Oru-star/Unique-DAP/ASSETS/Same_Sky_SJ1-3533NG/BOM.txt

3DX_Same_Sky_Supplier: Same Sky
3DX_Same_Sky_Description: 3.5 mm Right-Angle Stereo Jack, 3 Pin PCB Mount, Isolated Ground
3DX_Same_Sky_Model Number: SJ1-3533NG
