Oru-star/Unique-DAP/Bom.csv

Category | RefDes | Qty | Item / value | Manufacturer | MPN / candidate | Datasheet / manufacturer reference | Purchase / distributor link | Unit price (INR) | Unit price (USD) | Extended price (INR) | Extended price (USD) | Price basis / source note | Status | Source URL | Engineering audit notes | Price confidence | FX rate used (INR per USD)
Display | DISP1 | 1 | 3.16-in reflective memory LCD, 336 × 536, serial interface | Sharp | LS032B7DD02 | https://global.sharp/products/device/lineup/selection/lcd/mobile/index.html | https://www.digikey.in/en/products/detail/sharp-microelectronics/LS032B7DD02/23349498 | 3739.83 | 39.8483 | 3739.83 | 39.85 | Existing BOM price; reconfirm supplier/stock | VERIFY |  | Sharp confirms 3.16 in, 336×536, serial reflective display. Product brief states 5 V input; verify the complete panel power/logic requirements and FPC pinout against the exact revision before PCB release. | Exact DigiKey India listing observed; price can change | 93.8516
DAC | IC1 | 1 | 32-bit stereo audio DAC | ESS Technology | ES9038Q2M | https://www.mouser.in/c/?q=ES9038Q2M | https://www.mouser.in/c/?q=ES9038Q2M | 1967.96 | 20.9688 | 1967.96 | 20.97 | Mouser India single-unit listing | BUY | https://www.mouser.in/en/ProductDetail/ESS-Technology/ES9038Q2M | Exact DAC MPN. Verify exposed-pad/package land pattern, analog/digital supply rails, MCLK limits and output topology against the current datasheet. | Legacy price from earlier draft; recheck at checkout | 93.8516
Power IC | U1 | 1 | 3.7-A boost converter | Texas Instruments | TPS61023DRLR | https://www.ti.com/product/TPS61023/part-details/TPS61023DRLR | https://www.digikey.in/en/products/result?keywords=TPS61023DRLR | 116.56 | 1.242 | 116.56 | 1.24 | Existing BOM price; reconfirm at checkout | BUY | https://www.mouser.in/ | TI calls 3.7 A the valley switch-current limit, NOT guaranteed 3.7 A output current. 74438357010 is listed by TI as a recommended 1 µH inductor; re-check peak current, thermal and output-current budget. | Legacy price from earlier draft; recheck at checkout | 93.8516
Power IC | U2 | 1 | Buck-boost converter | Texas Instruments | TPS63021DSJR | https://www.ti.com/product/TPS63021/part-details/TPS63021DSJR | https://www.digikey.in/en/products/detail/texas-instruments/TPS63021DSJR/2271632 | 384.11 | 4.0927 | 384.11 | 4.09 | Existing BOM price; reconfirm at checkout | BUY |  | Active TI 3.3 V buck-boost part. Check inductor selection and output-current capability at battery minimum voltage. | Legacy price from earlier draft; recheck at checkout | 93.8516
Charger IC | U3 | 1 | 1-cell Li-ion/Li-poly charger with power-path management | Texas Instruments | BQ25895RTWR | https://www.ti.com/product/BQ25895 | https://www.digikey.in/en/products/detail/texas-instruments/BQ25895RTWR/5214018 | 321.05 | 3.4208 | 321.05 | 3.42 | Existing BOM price; reconfirm at checkout | VERIFY |  | 1-cell charger, 24-WQFN, max 5 A charge-current family. Confirm NTC/TS pin bias, battery profile, power-path and thermal layout. Do not omit battery temperature sensing without a documented safe configuration. | Exact DigiKey India listing observed; price can change | 93.8516
USB-C controller | U4 | 1 | USB Type-C configuration channel controller | Texas Instruments | TUSB320LAIRWBR | https://www.ti.com/product/TUSB320LAI/part-details/TUSB320LAIRWBR | https://www.digikey.in/en/products/detail/texas-instruments/TUSB320LAIRWBR/5722618 | 174.05 | 1.8545 | 174.05 | 1.85 | DigiKey India, qty 1 | BUY | https://www.digikey.in/en/products/detail/texas-instruments/TUSB320LAIRWBR/5722618 | Active Type-C CC controller; verify UFP/DFP/DRP role configuration and CC wiring against the intended charging/data port topology. | Exact DigiKey India listing observed; price can change | 93.8516
Headphone amplifier | U5 | 1 | Stereo DirectDrive headphone amplifier | Analog Devices / Maxim | MAX97220AETE+T | https://www.analog.com/en/products/max97220a.html | https://www.digikey.in/en/products/detail/analog-devices-inc-maxim-integrated/MAX97220AETE-T/2744332 | 245.56 | 2.6165 | 245.56 | 2.62 | DigiKey India, qty 1; replaces prior BOM estimate | BUY | https://www.digikey.in/en/products/detail/analog-devices-inc-maxim-integrated/MAX97220AETE-T/2744332 | Exact orderable suffix is MAX97220AETE+T. 16-TQFN; verify exposed-pad and analog supply/charge-pump capacitor layout. | Exact DigiKey India listing observed; price can change | 93.8516
MCU module | U6 | 1 | ESP32-S3 Wi-Fi/Bluetooth module; 8 MB flash + 8 MB PSRAM | Espressif | ESP32-S3-WROOM-1-N8R8 | https://www.espressif.com/en/products/modules/esp32-s3-wroom-1 | https://www.digikey.in/en/products/detail/espressif-systems/ESP32-S3-WROOM-1-N8R8/16705630 | 603.88 | 6.4344 | 603.88 | 6.43 | Existing BOM price; reconfirm exact suffix and supplier | VERIFY |  | Exact module is 8 MB Quad-SPI flash + 8 MB Octal-SPI PSRAM; check GPIO restrictions for octal PSRAM and antenna keepout. | Exact DigiKey India listing observed; price can change | 93.8516
USB-C receptacle | J1 | 1 | USB 2.0 Type-C top-mount receptacle | GCT | USB4105-GF-A | https://gct.co/connector/usb4105 | https://www.digikey.in/en/products/detail/gct/USB4105-GF-A/11198510 | 76.44 | 0.8145 | 76.44 | 0.81 | DigiKey India, qty 1 | VERIFY | https://www.digikey.in/en/products/detail/gct/USB4105-GF-A/11198510 | USB 2.0 Type-C receptacle. Verify footprint, shell stakes, orientation, CC pins and whether this is the charge-only or audio/data port. | Exact DigiKey India listing observed; price can change | 93.8516
Battery header | J2 | 1 | 2-position 2.54 mm straight through-hole pin header | Samtec | TSW-102-07-G-S | https://www.samtec.com/products/tsw-102-07-g-s | https://www.digikey.in/en/products/result?keywords=TSW-102-07-G-S | 20.07 | 0.2138 | 20.07 | 0.21 | Existing BOM price; reconfirm supplier | VERIFY |  | 2-pin 2.54 mm header is not polarized. For a LiPo battery this is a shorting/reverse-connection risk; prefer a keyed, locking battery connector matched to battery lead. | Legacy price from earlier draft; recheck at checkout | 93.8516
Programming header | J3 | 1 | 5-position 2.54 mm straight through-hole pin header | Samtec | TSW-105-07-G-S | https://www.samtec.com/products/tsw-105-07-g-s | https://www.digikey.in/en/products/result?keywords=TSW-105-07-G-S | 40.66 | 0.4332 | 40.66 | 0.43 | Existing BOM price; reconfirm supplier | BUY |  | 5-pin 2.54 mm header candidate; verify pin order, mating housing and programming fixture. | Legacy price from earlier draft; recheck at checkout | 93.8516
Display FPC connector | J4 | 1 | 10-position 0.5 mm FPC/FFC ZIF connector, right-angle | Hirose | FH34SRJ-10S-0.5SH(50) | https://www.hirose.com/en/product/p/CL0580-1251-5-50 | https://www.digikey.in/en/products/detail/hirose-electric-co-ltd/FH34SRJ-10S-0-5SH-50/3880296 | 116.57 | 1.2421 | 116.57 | 1.24 | Mouser India, qty 1 | VERIFY | https://www.mouser.in/en/ProductDetail/Hirose-Connector/FH34SRJ-10S-05SH50 | Hirose confirms 10-position, 0.5 mm, ZIF, right-angle, 0.3 mm FPC. Confirm contact orientation and exact Sharp flex thickness/pinout. | Exact DigiKey India listing observed; price can change | 93.8516
Headphone jack | J5 | 1 | 3.5 mm stereo TRS right-angle through-hole jack, unswitched | Same Sky / CUI Devices | SJ1-3533NG | https://www.digikey.in/en/products/detail/same-sky-formerly-cui-devices/SJ1-3533NG/738701 | https://www.digikey.in/en/products/detail/same-sky-formerly-cui-devices/SJ1-3533NG/738701 | 160.74 | 1.7127 | 160.74 | 1.71 | DigiKey India, qty 1 | BUY | https://www.digikey.in/en/products/detail/same-sky-formerly-cui-devices/SJ1-3533NG/738701 | Active unswitched stereo TRS jack. Verify PCB footprint and mechanical insertion depth with enclosure. | Exact DigiKey India listing observed; price can change | 93.8516
Ferrite bead | FB1 | 1 | 600 Ω @ 100 MHz ferrite bead, 0805 | Murata | BLM21PG601SN1D | https://www.murata.com/en-global/products/productdetail?partno=BLM21PG601SN1D | https://www.digikey.in/en/products/detail/murata-electronics/BLM21PG601SN1D/24763118 | 11.47 | 0.1222 | 11.47 | 0.12 | Existing BOM price; reconfirm supplier | VERIFY |  | Active 0805 600 Ω @100 MHz ferrite bead. Verify DC current and DCR against rail load; impedance alone is not enough. | Exact DigiKey India listing observed; price can change | 93.8516
Power inductor | L1 | 1 | 1.0 µH shielded power inductor; TI-listed candidate | Würth Elektronik | 74438357010 | https://www.we-online.com/en/components/products/WE-MAPI | https://in.element14.com/wurth-elektronik/74438357010/inductor-1uh-7-4a-20-shielded/dp/2842181 | 161.46 | 1.7204 | 161.46 | 1.72 | Existing BOM price; supplier listing approx. ₹162.82; reconfirm | HOLD | https://in.element14.com/wurth-elektronik/74438357010/inductor-1uh-7-4a-20-shielded/dp/2842181 | TI-recommended 1 µH candidate for TPS61023. Datasheet electrical current ratings differ from some distributor summary fields; compare the manufacturer's current datasheet and operating peak current before approval. | Legacy price from earlier draft; recheck at checkout | 93.8516
Power inductor | L2 | 1 | 1.5 µH shielded power inductor; Coilcraft candidate | Coilcraft | XFL4020-152ME | https://www.coilcraft.com/en-us/products/power/shielded-inductors/xfl/xfl4020/ | https://www.digikey.in/en/products/result?keywords=XFL4020-152ME |  |  |  |  | No verified India single-unit price found; request quote | HOLD |  | Generic family suffix may not be a complete orderable MPN; Coilcraft/Mouser show MEB/MEC variants. Confirm exact suffix and verify Isat/DCR against TPS63021 worst-case inductor current. | No verified price; quotation required | 93.8516
Power inductor | L3 | 1 | 2.2 µH shielded power inductor | Murata | DFE322512F-2R2M=P2 | https://www.murata.com/en-global/products/productdetail?partno=DFE322512F-2R2M%3DP2 | https://www.digikey.in/en/products/detail/murata-electronics/DFE322512F-2R2M-P2/9815914 | 46.82 | 0.4989 | 46.82 | 0.5 | DigiKey India, qty 1 | HOLD | https://www.digikey.in/en/products/detail/murata-electronics/DFE322512F-2R2M-P2/9815914 | Price/listing found, but L3 function is not explicit in the BOM. HOLD until assigned rail and Isat/DCR are checked at worst-case current. | Exact DigiKey India listing observed; price can change | 93.8516
Oscillator | Y1 | 1 | 40.000 MHz CMOS oscillator, 3.3 V, 4-pad 3.2 × 2.5 mm | Abracon | ASE-40.000MHZ-L-C-T | https://abracon.com/Oscillators/ASE.pdf | https://www.digikey.in/en/products/detail/abracon-llc/ASE-40-000MHZ-L-C-T/5980161 | 99.37 | 1.0588 | 99.37 | 1.06 | DigiKey India, qty 1 | VERIFY | https://www.digikey.in/en/products/detail/abracon-llc/ASE-40-000MHZ-L-C-T/5980161 | 40 MHz oscillator price/link found. HOLD: confirm ES9038Q2M MCLK requirement and supported sample-rate clock plan; 40 MHz may not provide clean integer-family clocks for 44.1/48 kHz. | Exact DigiKey India listing observed; price can change | 93.8516
Capacitor | C1,C8-C10,C13,C14,C30 | 7 | 10 µF MLCC, 0603; suggested 10 V X5R | Samsung (candidate) | CL10A106KP8NNND | https://www.samsungsem.com/global/product/passive-component/mlcc.do | https://www.digikey.in/en/products/result?keywords=CL10A106KP8NNND | 19.11 | 0.2036 | 133.77 | 1.43 | DigiKey India single-unit price; limited stock shown | VERIFY | https://www.digikey.in/en/products/detail/samsung-electro-mechanics/CL10A106KP8NNND/3894249 | 10 µF 0603 candidate. Verify voltage rating, X5R effective capacitance under DC bias, and temperature range on the actual rail. | Legacy price from earlier draft; recheck at checkout | 93.8516
Capacitor | C2,C16-C21,C23,C28,C31 | 10 | 100 nF MLCC, 0603; suggested 50 V X7R | Murata | GRM188R71H104KA93D | https://www.murata.com/en-global/products/productdetail?partno=GRM188R71H104KA93D | https://www.digikey.in/en/products/detail/murata-electronics/GRM188R71H104KA93D/587143 | 15.29 | 0.1629 | 152.9 | 1.63 | DigiKey India single-unit price | VERIFY | https://www.digikey.in/en/products/detail/murata-electronics/GRM188R71H104KA93D/587143 | 100 nF, 50 V, X7R 0603 exact part is marked obsolete on DigiKey. Select a current-life replacement after checking tolerance and package. | Legacy price from earlier draft; recheck at checkout | 93.8516
Capacitor | C3-C6 | 4 | 22 µF MLCC, 0603, 6.3 V X5R | Yageo | CC0603MRX5R5BB226 | https://www.yageo.com/en/ProductSearch/Index | https://www.digikey.in/en/products/result?keywords=CC0603MRX5R5BB226 | 54.46 | 0.5803 | 217.84 | 2.32 | Existing BOM price; reconfirm exact stock/price | HOLD |  | 22 µF, 6.3 V in 0603. HOLD: 6.3 V rating gives little margin on a 5 V rail; check DC-bias derating/effective capacitance and rail assignment. | Legacy price from earlier draft; recheck at checkout | 93.8516
Capacitor | C7,C12,C24-C27,C29,C32,C34,C35 | 10 | 1 µF MLCC, 0603, 16 V X7R | TDK (direct substitute candidate) | C1608X7R1C105K080AC | https://product.tdk.com/en/search/capacitor/ceramic/mlcc/info?part_no=C1608X7R1C105K080AC | https://www.digikey.in/en/products/result?keywords=C1608X7R1C105K080AC | 11.47 | 0.1222 | 114.7 | 1.22 | DigiKey India direct substitute price; original Murata MPN is obsolete | VERIFY | https://www.digikey.in/en/products/detail/murata-electronics/GRM188R71C105KA12D/965914 | Check exact MPN, package, ratings, lifecycle, footprint and application requirements against manufacturer datasheet. | Legacy price from earlier draft; recheck at checkout | 93.8516
Capacitor | C15,C22,C36-C39 | 6 | 4.7 µF MLCC, 0603; suggested 10 V X7R | Murata (candidate) | GRM188R71A475KE15D | https://www.murata.com/en-global/products/productdetail?partno=GRM188R71A475KE15D | https://www.digikey.in/en/products/result?keywords=GRM188R71A475KE15D |  |  |  |  | No verified single-unit price found; request quote | VERIFY |  | 4.7 µF 0603 candidate. Exact price not verified; check stock, voltage rating and DC-bias derating. | No verified price; quotation required | 93.8516
Capacitor | C11 | 1 | 47 nF MLCC, 0603; suggested 25 V X7R | Murata | GRM188R71E473KA61D | https://www.murata.com/en-global/products/productdetail?partno=GRM188R71E473KA61D | https://www.digikey.in/en/products/result?keywords=GRM188R71E473KA61D |  |  |  |  | No verified single-unit price found; request quote | VERIFY |  | 47 nF 0603 candidate. Exact price not verified; verify dielectric, tolerance and voltage rating. | No verified price; quotation required | 93.8516
Capacitor | C33 | 1 | 560 pF C0G/NP0, 50 V, 0603 | Murata | GRM1885C1H561JA01D | https://www.murata.com/en-global/products/productdetail?partno=GRM1885C1H561JA01D | https://www.digikey.in/en/products/detail/murata-electronics/GRM1885C1H561JA01D/586954 | 15.29 | 0.1629 | 15.29 | 0.16 | DigiKey India, qty 1; listing flags not recommended for new design | VERIFY | https://www.digikey.in/en/products/detail/murata-electronics/GRM1885C1H561JA01D/586954 | 560 pF C0G 50 V 0603 candidate. Verify lifecycle status and actual circuit function. | Legacy price from earlier draft; recheck at checkout | 93.8516
Resistor | R4,R6,R7,R9-R11,R15,R16,R18,R19,R27 | 11 | 10 kΩ, 1%, 0805 | Yageo | RC0805FR-0710KL | https://www.yageo.com/en/ProductSearch/Index | https://www.digikey.in/en/products/detail/yageo/RC0805FR-0710KL/730482 | 3.249 | 0.0346 | 35.74 | 0.38 | DigiKey India, 10-piece price break | BUY | https://www.digikey.in/en/products/detail/yageo/RC0805FR-0710KL/730482 | 10 kΩ 1%, 0805 Yageo candidate; verify required resistor power rating and actual design quantity. | Legacy price from earlier draft; recheck at checkout | 93.8516
Resistor | R17,R20-R26 | 8 | 20 kΩ, 1%, 0805 | TE Connectivity | CRG0805F20K | https://www.te.com/en/product-1622825-1.html | https://www.digikey.in/en/products/detail/te-connectivity-passive-product/CRG0805F20K/2380867 | 9.51 | 0.1013 | 76.08 | 0.81 | DigiKey India single-unit price | BUY | https://www.digikey.in/en/products/detail/te-connectivity-passive-product/CRG0805F20K/2380867 | 20 kΩ 1%, 0805 TE candidate; confirm exact package/power rating. | Legacy price from earlier draft; recheck at checkout | 93.8516
Resistor | R5,R8 | 2 | 260 Ω, 1%, 0805 | Yageo (candidate) | RC0805FR-07260RL | https://www.yageo.com/en/ProductSearch/Index | https://www.digikey.in/en/products/result?keywords=RC0805FR-07260RL |  |  |  |  | Exact MPN price not verified; request quote | VERIFY |  | 260 Ω Yageo candidate. Exact listing/price not confirmed; check whether 260 Ω is intentional versus nearby standard value. | No verified price; quotation required | 93.8516
Resistor | R13,R14 | 2 | 4.7 kΩ, 1%, 0805 | Yageo | RC0805FR-074K7L | https://www.yageo.com/en/ProductSearch/Index | https://www.digikey.in/en/products/detail/yageo/RC0805FR-074K7L/727929 | 9.56 | 0.1019 | 19.12 | 0.2 | DigiKey India single-unit price | VERIFY | https://www.digikey.in/en/products/detail/yageo/RC0805FR-074K7L/727929 | 4.7 kΩ 1%, 0805 candidate; verify tolerance/power. | Legacy price from earlier draft; recheck at checkout | 93.8516
Resistor | R1 | 1 | 100 kΩ, 1%, 0805 | Yageo | RC0805FR-07100KL | https://www.yageo.com/en/ProductSearch/Index | https://www.digikey.in/en/products/detail/yageo/RC0805FR-07100KL/730491 | 10.51 | 0.112 | 10.51 | 0.11 | DigiKey India single-unit price | VERIFY | https://www.digikey.in/en/products/detail/yageo/RC0805FR-07100KL/730491 | 100 kΩ 1%, 0805 candidate; verify tolerance/power. | Legacy price from earlier draft; recheck at checkout | 93.8516
Resistor | R2 | 1 | 27.4 kΩ, 1%, 0805 | Yageo | RC0805FR-0727K4L | https://www.yageo.com/en/ProductSearch/Index | https://www.digikey.in/en/products/detail/yageo/RC0805FR-0727K4L/727782 | 9.56 | 0.1019 | 9.56 | 0.1 | DigiKey India single-unit price | VERIFY | https://www.digikey.in/en/products/detail/yageo/RC0805FR-0727K4L/727782 | 27.4 kΩ 1%, 0805 candidate; verify tolerance/power. | Legacy price from earlier draft; recheck at checkout | 93.8516
Resistor | R3 | 1 | 200 kΩ, 1%, 0805 | Yageo | RC0805FR-07200KL | https://www.yageo.com/en/ProductSearch/Index | https://www.digikey.in/en/products/detail/yageo/RC0805FR-07200KL/730671 | 9.56 | 0.1019 | 9.56 | 0.1 | DigiKey India single-unit price | VERIFY | https://www.digikey.in/en/products/detail/yageo/RC0805FR-07200KL/730671 | 200 kΩ 1%, 0805 candidate; verify tolerance/power. | Legacy price from earlier draft; recheck at checkout | 93.8516
Resistor | R12 | 1 | 900 kΩ, 1%, 0805 | Yageo (candidate) | RC0805FR-07900KL | https://www.yageo.com/en/ProductSearch/Index | https://www.digikey.in/en/products/result?keywords=RC0805FR-07900KL |  |  |  |  | Exact MPN price not verified; request quote | VERIFY |  | 900 kΩ candidate; exact orderable MPN/price not verified. Check if value is intentional and ensure Yageo part number exists. | No verified price; quotation required | 93.8516
Rotary encoder | SW2,SW3 | 2 | Incremental rotary encoder with push switch; vertical, 20 mm body class | ALPS Alpine | EC11E family — EC11E15204A3 price candidate | https://tech.alpsalpine.com/e/products/category/enc/ | https://www.digikey.in/en/products/detail/alps-alpine/EC11E15204A3/21721644 | 421.38 | 4.4899 | 842.76 | 8.98 | DigiKey India, exact EC11E15204A3 candidate; note this exact variant has no built-in push switch | HOLD | https://www.digikey.in/en/products/detail/alps-alpine/EC11E15204A3/21721644 | Check exact MPN, package, ratings, lifecycle, footprint and application requirements against manufacturer datasheet. | Price observed for candidate only; functional mismatch remains | 93.8516
Slide / push controls | SW1,SW2-BOOT1,SW4-SW6 | 5 | Control switches; symbol says SW_Push but assigned footprint is Copal CHS-01A slide switch | Nidec Copal | CHS-01A | https://www.nidec.com/en/product/search/category/B102/M101/S100/ | https://www.tanotis.com/products/nidec-copal-electronics-chs-01a-dip-switch-1pos-spst-slide-smd | 169.2 | 1.8028 | 846.0 | 9.01 | Tanotis India price incl. taxes/import duties; verify this is the intended switch function | HOLD | https://www.tanotis.com/products/nidec-copal-electronics-chs-01a-dip-switch-1pos-spst-slide-smd | CHS-01A is a slide/DIP switch, not a momentary pushbutton. Current SW_Push symbol/footprint mapping is inconsistent. HOLD until control function and footprint are reconciled. | Price observed; switch-function mismatch remains | 93.8516
Battery (off-board) | BAT1 (not a PCB footprint) | 1 | Single-cell 3.7 V Li-Po, 2500 mAh project candidate | WLY (project candidate) | WLY104050 — exact supplier/lead configuration TBD | https://www.google.com/search?q=WLY104050%202500mAh%203.7V%20LiPo%20battery | https://www.google.com/search?q=WLY104050%202500mAh%203.7V%20LiPo%20battery%20supplier |  |  |  |  | No reliable exact-match retail price found; quote required | HOLD |  | Check exact MPN, package, ratings, lifecycle, footprint and application requirements against manufacturer datasheet. | No verified price; quotation required | 93.8516
microSD card socket | J6 | 1 | microSD socket, SMT right-angle, push-push, top-mount; card-detect switch | Hirose Electric | DM3AT-SF-PEJM5 | https://www.hirose.com/product/document?clcode=CL0609-0031-0-00&documenttype=Drawing&lang=en | https://www.digikey.in/en/products/detail/hirose-electric-co-ltd/DM3AT-SF-PEJM5/2533565 | 339.2 | 3.6142 | 339.2 | 3.61 | DigiKey India, qty 1; push-in/push-out with switch contacts; verify suffix and footprint mapping | VERIFY | https://www.digikey.in/en/products/detail/hirose-electric-co-ltd/DM3AT-SF-PEJM5/2533565 | Correct Hirose DM3AT push-push, top-mount, right-angle SMT socket. It physically includes card-detect switch contacts; leave them electrically unconnected as requested. Verify footprint and switch-pad mapping. | Exact DigiKey India listing observed; price can change | 93.8516
Storage media | SD1 (off-board) | 1 | 128 GB microSDXC UHS-I memory card, Class 10 / U1 / A1; up to 140 MB/s read | SanDisk | SDSQUAB-128G-GN6MN | https://www.westerndigital.com/products/memory-cards/sandisk-ultra-uhs-i-microsd | https://indiastore-stage.westerndigital.com/store/sdsquab-128g-gn6mn.html | 909.0 | 9.6855 | 909.0 | 9.69 | Western Digital India store listing; price may change | VERIFY | https://indiastore-stage.westerndigital.com/store/sdsquab-128g-gn6mn.html | 128 GB microSDXC candidate. Confirm exact speed class, authenticity, supplier warranty and exFAT/FAT32 firmware support. | Legacy price from earlier draft; recheck at checkout | 93.8516
