Oru-star/Unique-DAP/ASSETS/Adafruit_4694_SHARP_Memory_Display_Reference.step

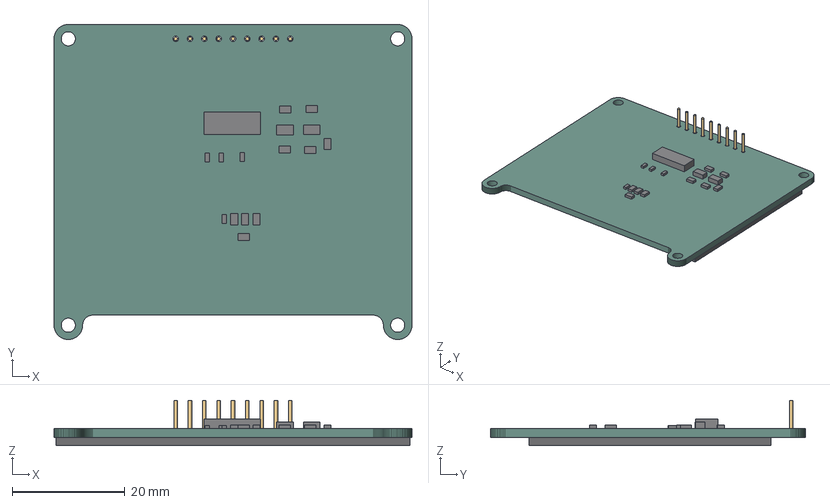
[picture p6: CAD file, 2026-10-27]
ASSETS/Adafruit_4694_SHARP_Memory_Display_Reference.step
63.5 x 55.9 x 7.99 mm
PCB_1p6mm_nominal
Display_module_envelope_estimated_thickness
Viewable_area_58p8x35p3mm
Header_pin_1_estimated
Header_pin_2_estimated
Header_pin_3_estimated
Header_pin_4_estimated
Header_pin_5_estimated
Header_pin_6_estimated
Header_pin_7_estimated
Header_pin_8_estimated
Header_pin_9_estimated
R1_0603-NO_estimated_envelope
R2_0603-NO_estimated_envelope
R3_0603-NO_estimated_envelope
C1_0603-NO_estimated_envelope
C2_0805_10MGAP_estimated_envelope
C3_0805-NO_estimated_envelope
FB1__0805_estimated_envelope
FB2__0805_estimated_envelope
U1_SOIC16_estimated_envelope
U2_SOT23-5_estimated_envelope
C4_0805-NO_estimated_envelope
C5_0805-NO_estimated_envelope
C6_0805-NO_estimated_envelope
C7_0805-NO_estimated_envelope
IC2_SOT23-6_estimated_envelope
C8_0805-NO_estimated_envelope
