Oru-star/Unique-DAP/ASSETS/FH34SRJ-10S-0.5SH_50_/FH34SRJ-10S-0.5SH_50_.step

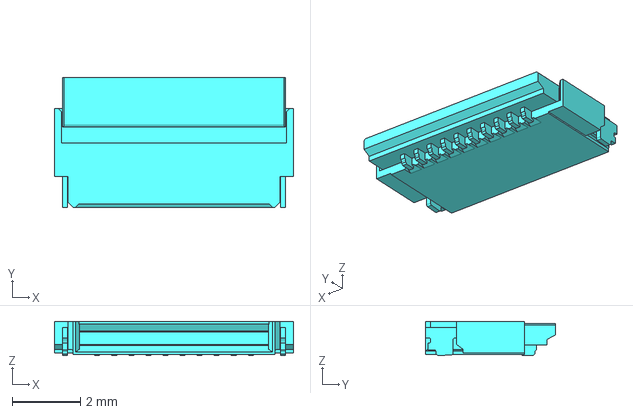
[picture p7: CAD file, 2026-10-27]
ASSETS/FH34SRJ-10S-0.5SH_50_/FH34SRJ-10S-0.5SH_50_.step
7.00 x 3.80 x 1.00 mm
