Oru-star/Unique-DAP/ASSETS/LIB_ES9038Q2M/ES9038Q2M/3D/ES9038Q2M.stp

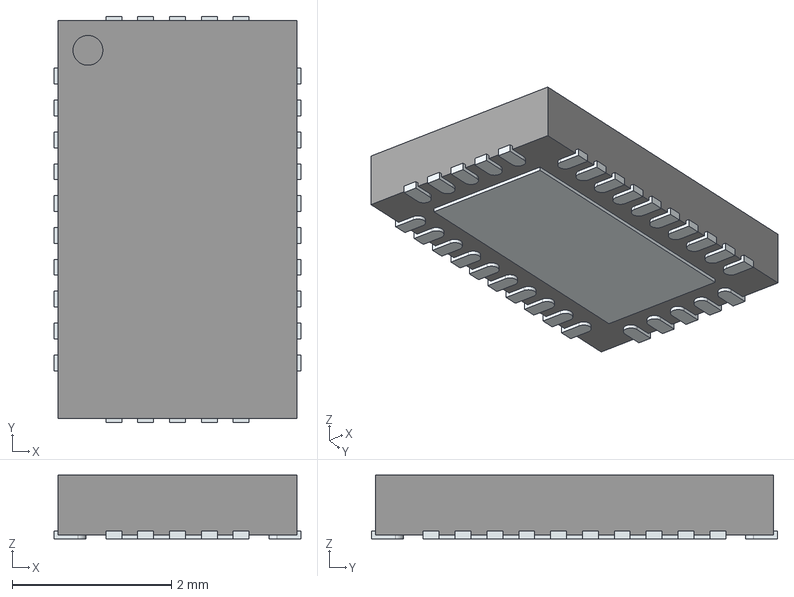
[picture p8: CAD file, 2026-11-07]
ASSETS/LIB_ES9038Q2M/ES9038Q2M/3D/ES9038Q2M.stp
3.10 x 5.10 x 0.8 mm
ThermalPin
PinsArrayLR
PinsArrayTB
