Oru-star/Unique-DAP/ASSETS/Same_Sky_SJ1-3533NG/Same_Sky_SJ1-3533NG.step

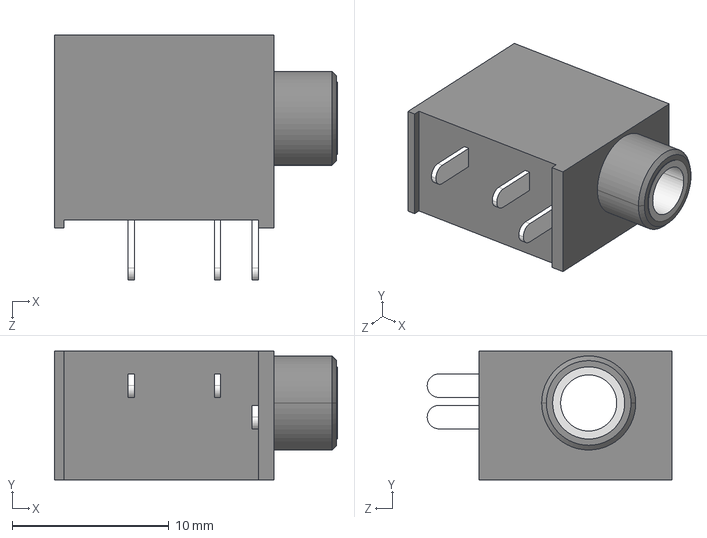
[picture p9: CAD file, 2026-11-11]
ASSETS/Same_Sky_SJ1-3533NG/Same_Sky_SJ1-3533NG.step
18.1 x 8.20 x 15.6 mm
