Oru-star/Unique-DAP/ASSETS/ul_TPS63021DSJR/DSJ0014A.stp

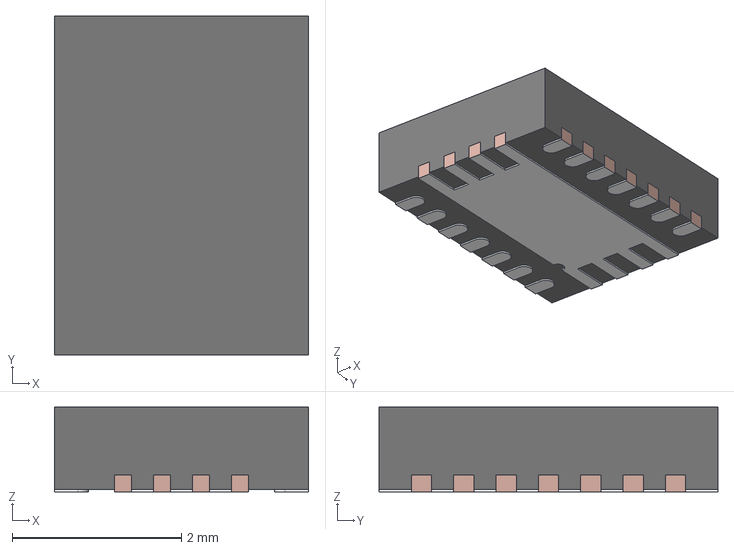
[picture p10: CAD file, 2026-11-07]
ASSETS/ul_TPS63021DSJR/DSJ0014A.stp
3.00 x 4.00 x 1.00 mm
FRAME
MOLD
