Oru-star/Unique-DAP/ASSETS/ul_TUSB320LAIRWBR/RWB0012A.stp

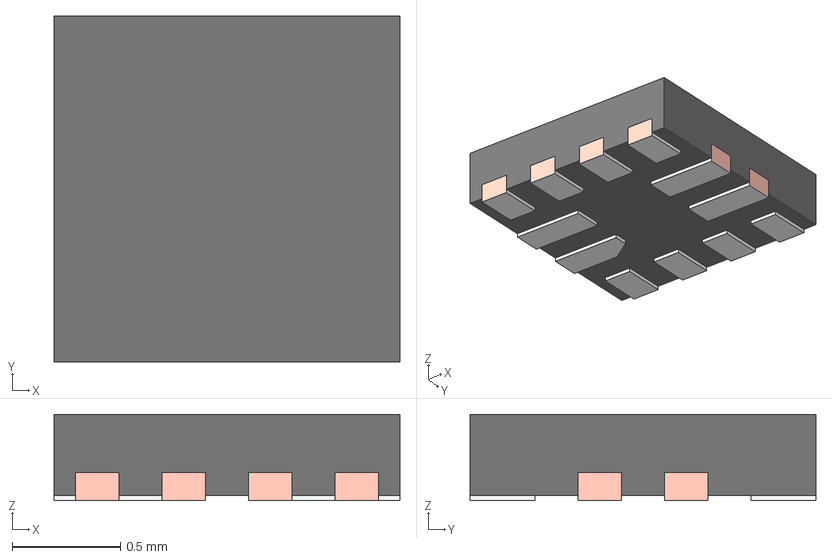
[picture p11: CAD file, 2026-11-07]
ASSETS/ul_TUSB320LAIRWBR/RWB0012A.stp
1.60 x 1.60 x 0.4 mm
FRAME-RWB0012A
BODY-QFN
