Oru-star/Unique-DAP/steps/Stl for prints/Right of Deck .stl

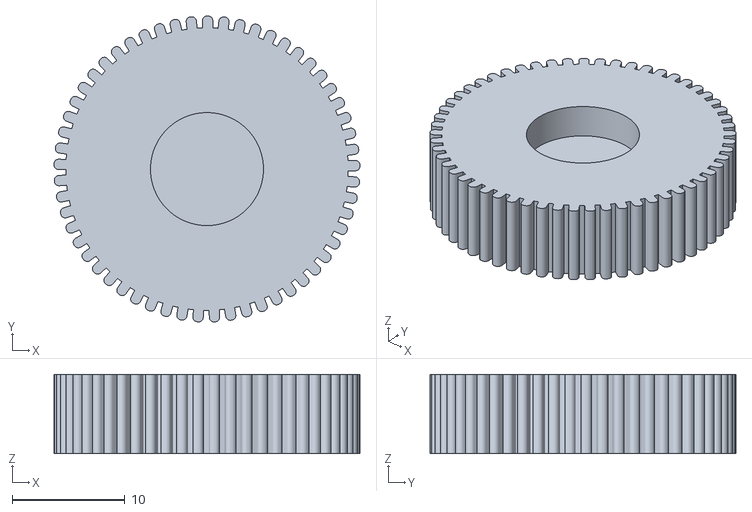
[picture p12: CAD file, 2026-11-11]
steps/Stl for prints/Right of Deck .stl
27.1 x 27.1 x 7.00
