Oru-star/Unique-DAP/ASSETS/Sharp_LS032B7DD02_Envelope_Approx.step

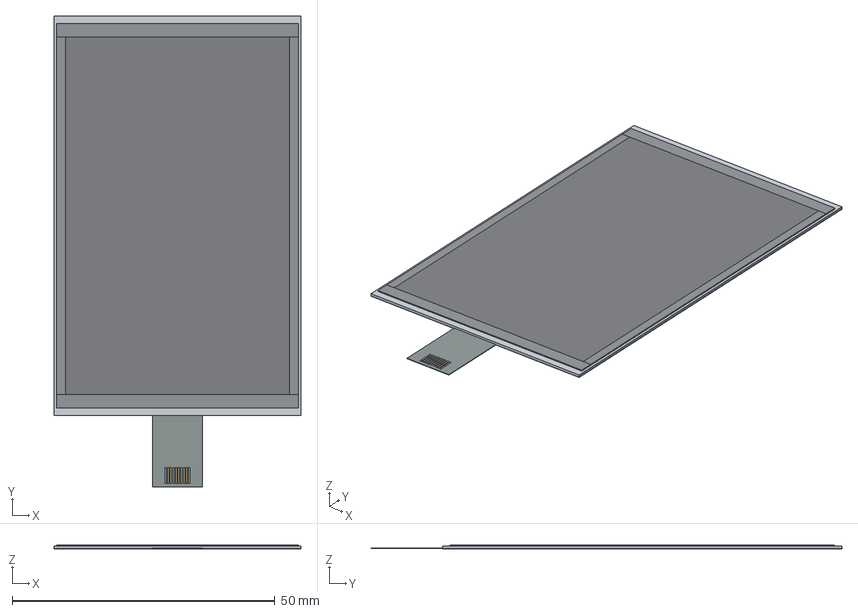
[picture p13: CAD file, 2026-10-27]
ASSETS/Sharp_LS032B7DD02_Envelope_Approx.step
47.0 x 89.6 x 0.705 mm
Bottom_polarizer_0p115mm
Glass_stack_0p400mm
Active_area_42p672x68p072mm
Top_polarizer_left_border
Top_polarizer_right_border
Top_polarizer_top_border
Top_polarizer_bottom_border
FPC_tail_approximate
FPC_contact_01_schematic
FPC_contact_02_schematic
FPC_contact_03_schematic
FPC_contact_04_schematic
FPC_contact_05_schematic
FPC_contact_06_schematic
FPC_contact_07_schematic
FPC_contact_08_schematic
FPC_contact_09_schematic
FPC_contact_10_schematic
