Oru-star/Unique-DAP/steps/Stl for prints/Top of the dap .stl

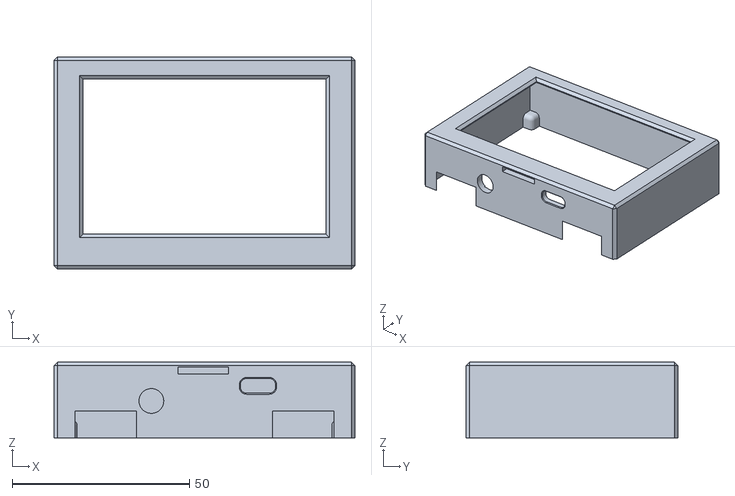
[picture p14: CAD file, 2026-11-11]
steps/Stl for prints/Top of the dap .stl
85.0 x 60.0 x 21.4
