Oru-star/Unique-DAP/ASSETS/EC11_Rotary_Encoder_Switched.step

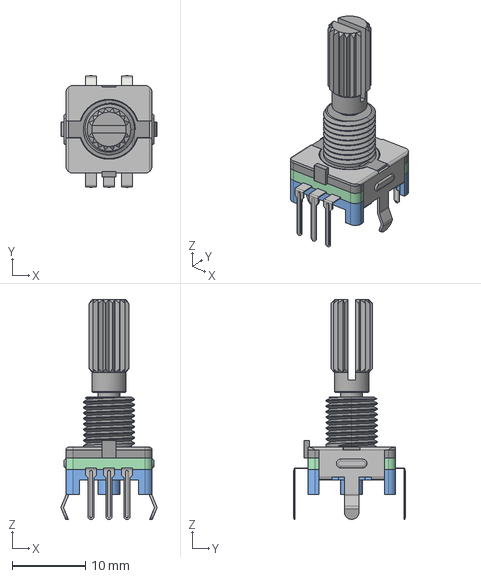
[picture p15: CAD file, 2026-10-27]
ASSETS/EC11_Rotary_Encoder_Switched.step
13.1 x 15.3 x 30.1 mm
