Oru-star/Unique-DAP/steps/Stl for prints/Back of deck .stl

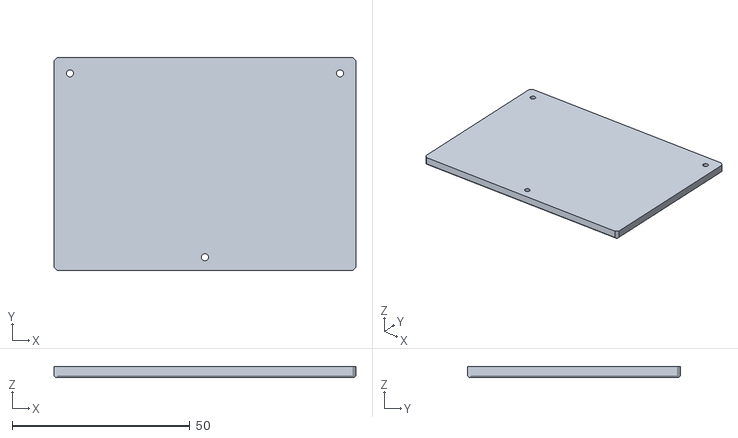
[picture p16: CAD file, 2026-11-11]
steps/Stl for prints/Back of deck .stl
85.0 x 60.0 x 3.00
