Oru-star/Unique-DAP/ASSETS/TPS61023DRLR/TPS61023DRLR.step

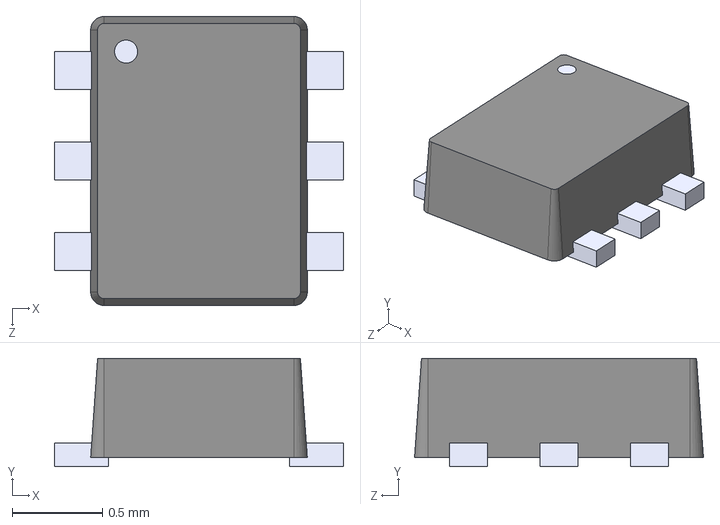
[picture p17: CAD file, 2026-11-07]
ASSETS/TPS61023DRLR/TPS61023DRLR.step
1.60 x 0.6 x 1.60 mm
