Oru-star/Unique-DAP/(list of files, cad)

Other CAD files:
steps/Stl for prints/LEFT SCROLL WHEEL.stl
ASSETS/LIB_ES9038Q2M/ES9038Q2M/Allegro/qfn40p300x500x80-31n-d.psm
ASSETS/LIB_ES9038Q2M/ES9038Q2M/DEHDL/es9038q2m/chips/chips.prt
steps/Main-dap.f3z
