Oru-star/Unique-DAP/ASSETS/carrier-orange pi zero 3w.pdf

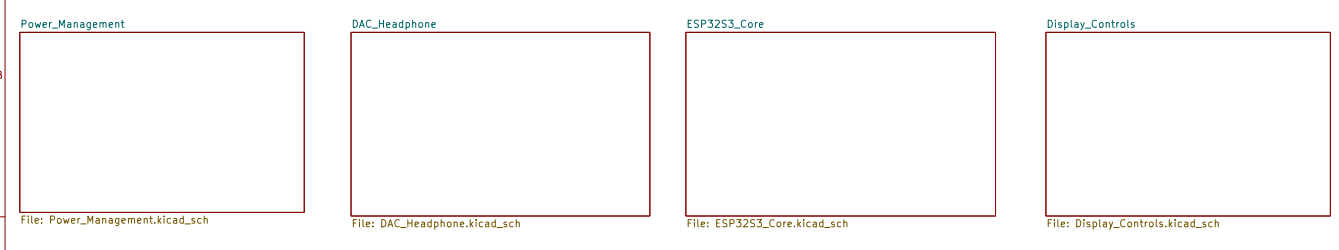
[picture p18: page 1]

Size: A4 | Rev:
KiCad E.D.A. 10.0.6 | Id: 1/5

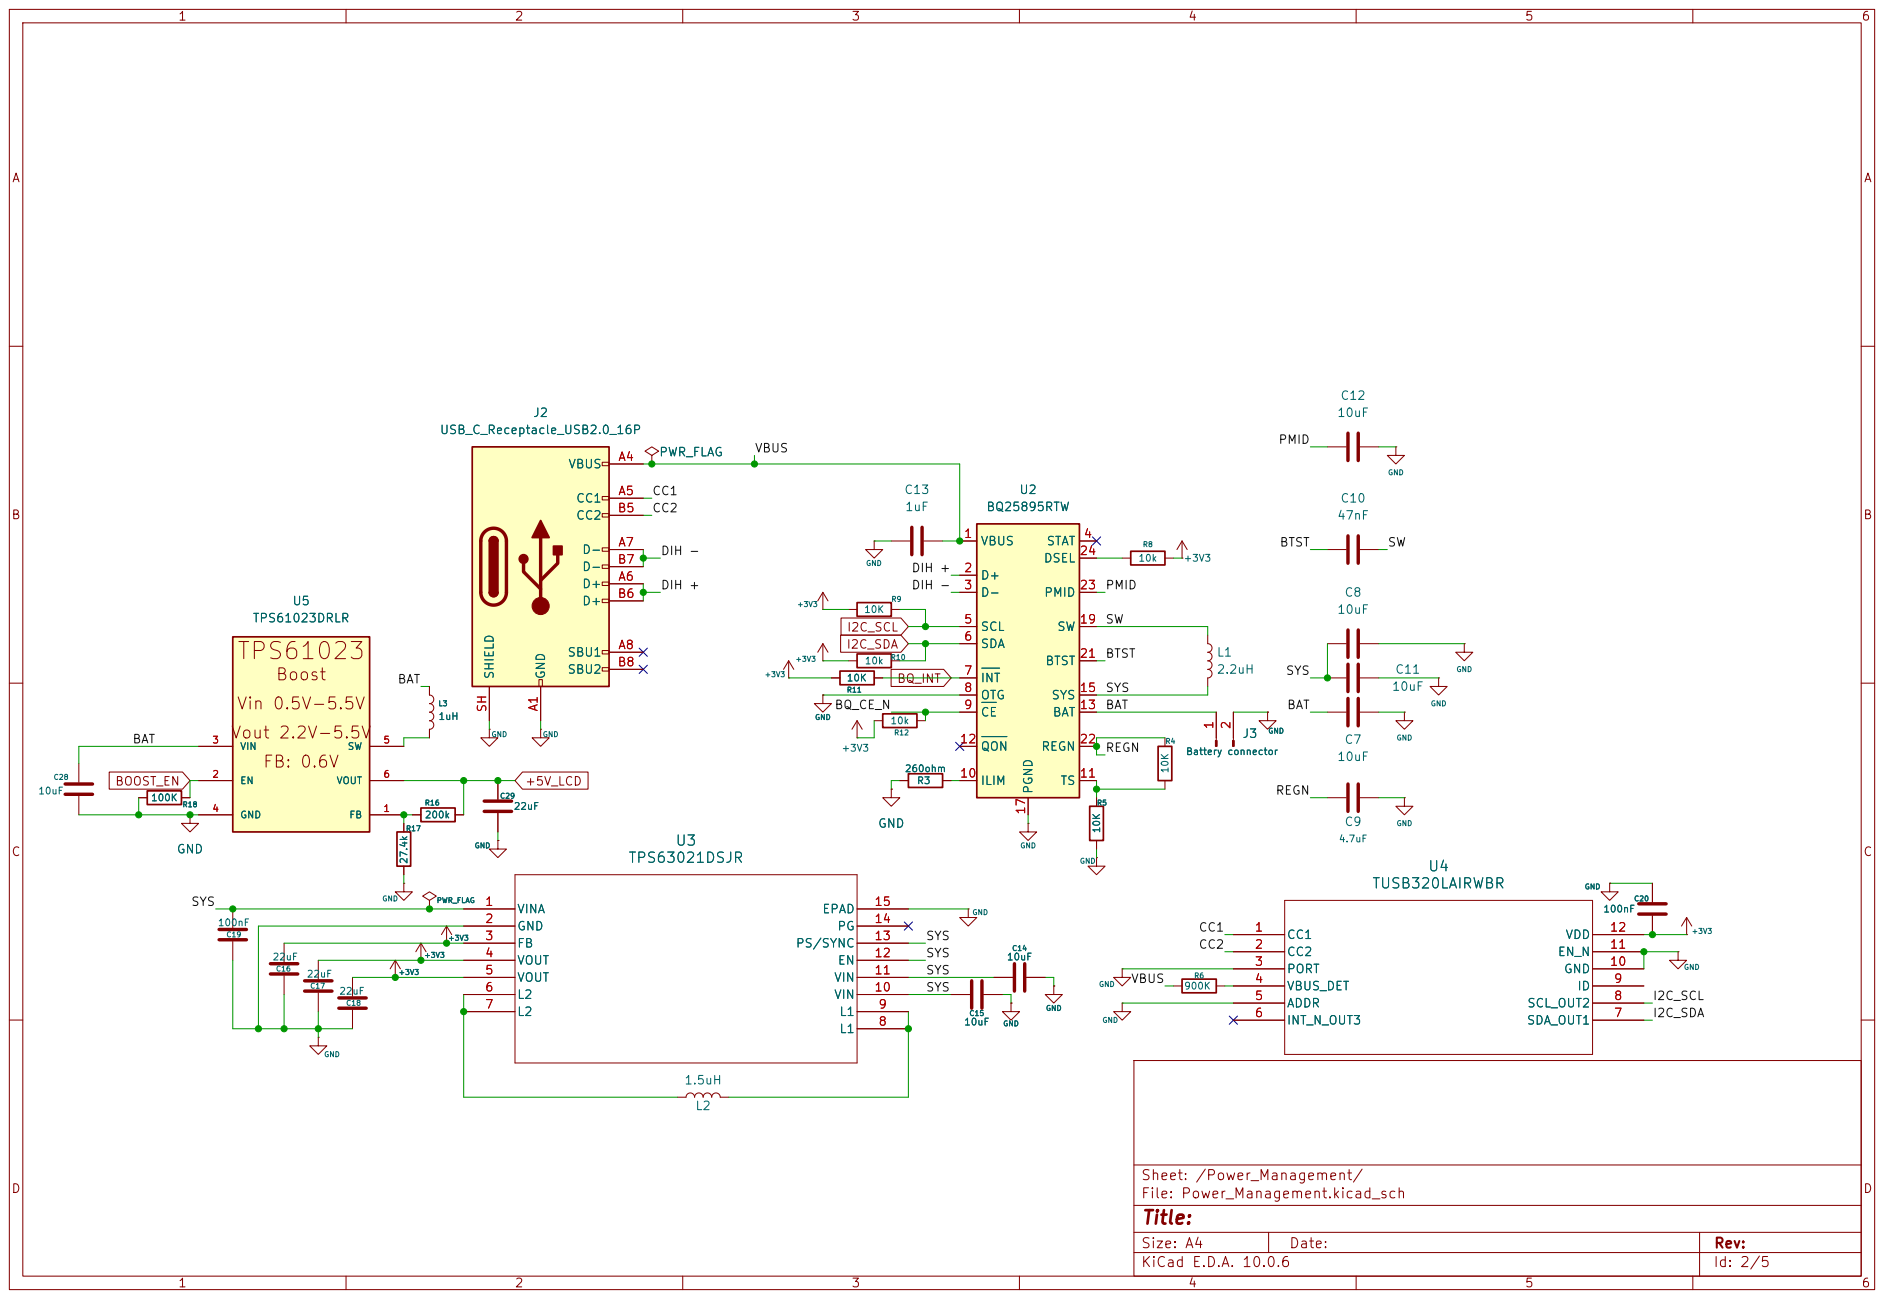
[picture p19: page 2]

VBUS
SW 19 BTST 21 REGN 22 PMID 23 DSEL 24 U2 BQ25895RTW
SW 19 BTST 21 REGN 22 PMID 23 DSEL 24

VOUT 4
VOUT 5
L2 6 | SYS

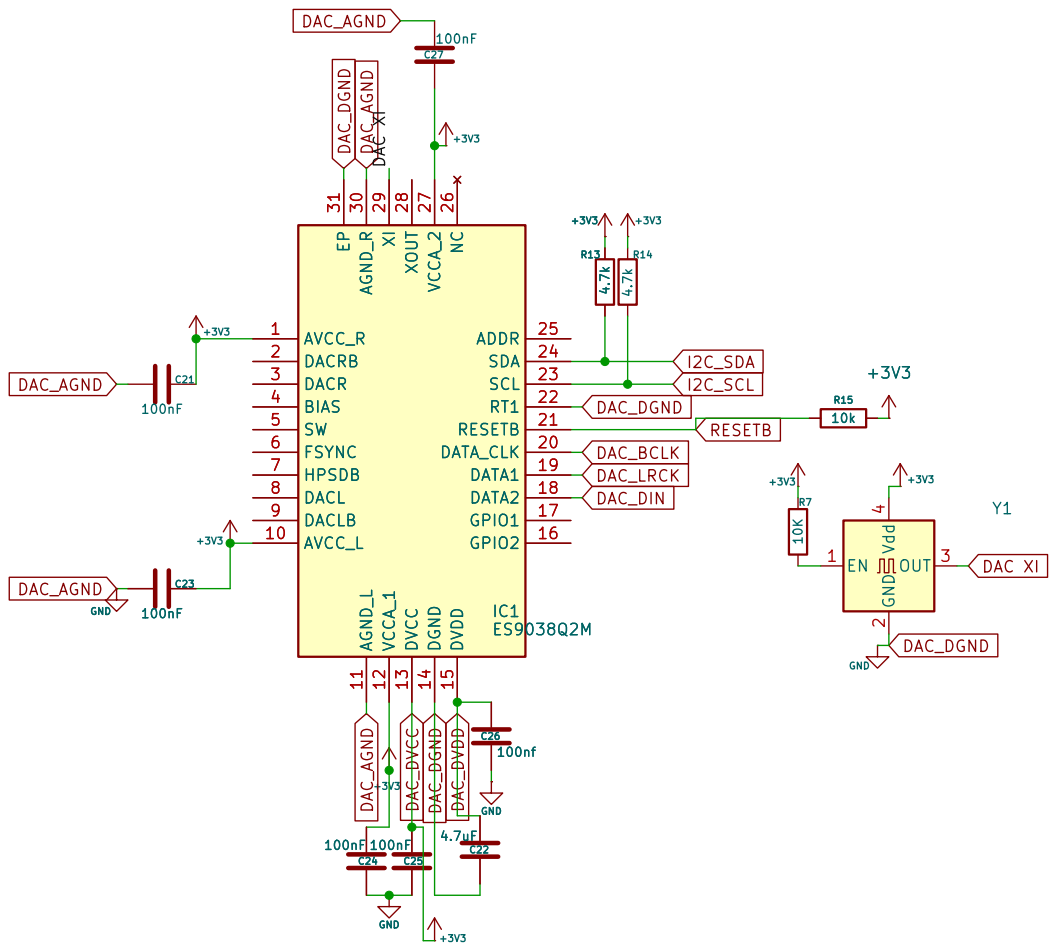
[picture p20: page 3]

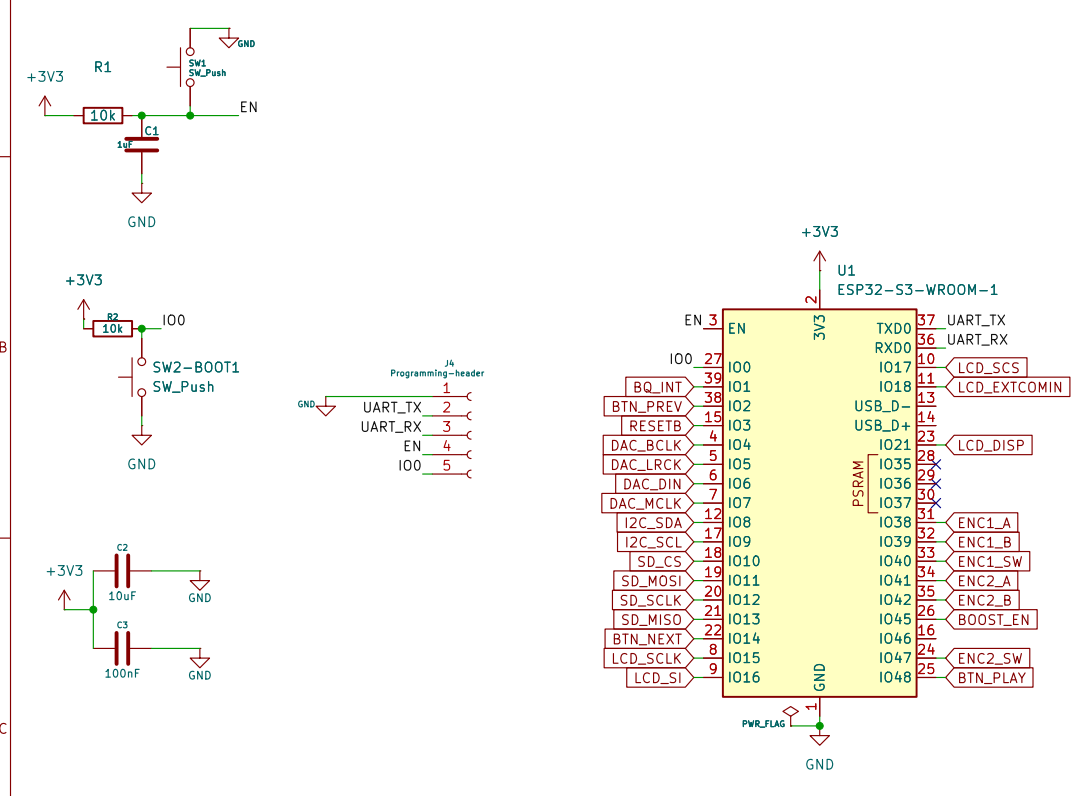
[picture p21: page 4]

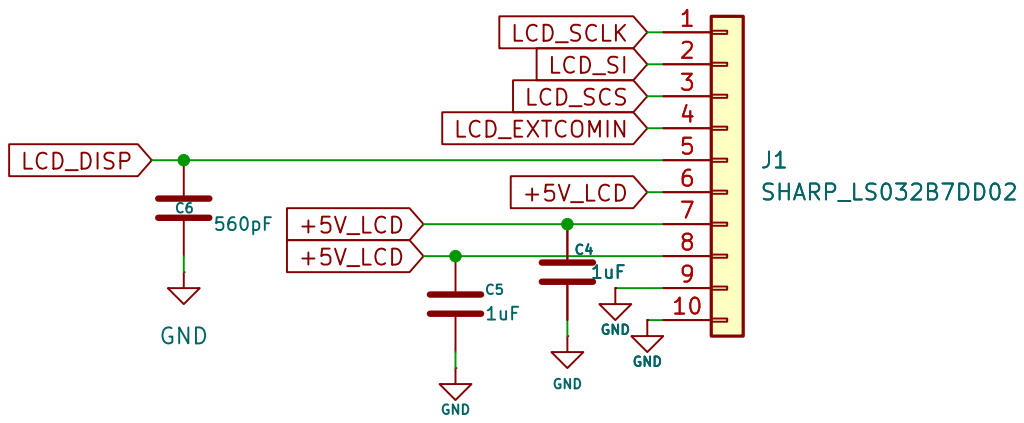
[picture p22: page 5]
