Oru-star/Unique-DAP/(list of files, drawings)

Other design files:
ASSETS/LIB_ES9038Q2M/ES9038Q2M/Altium/ES9038Q2M.SchLib
ASSETS/LIB_ES9038Q2M/ES9038Q2M/Altium/QFN40P300X500X80-31N-D.PcbLib
