Oru-star/Unique-DAP/DAP'S PCB/DAP'S PCB.kicad_pcb

## KiCad design DAP'S PCB/DAP'S PCB.kicad_pcb (2026-11-11)

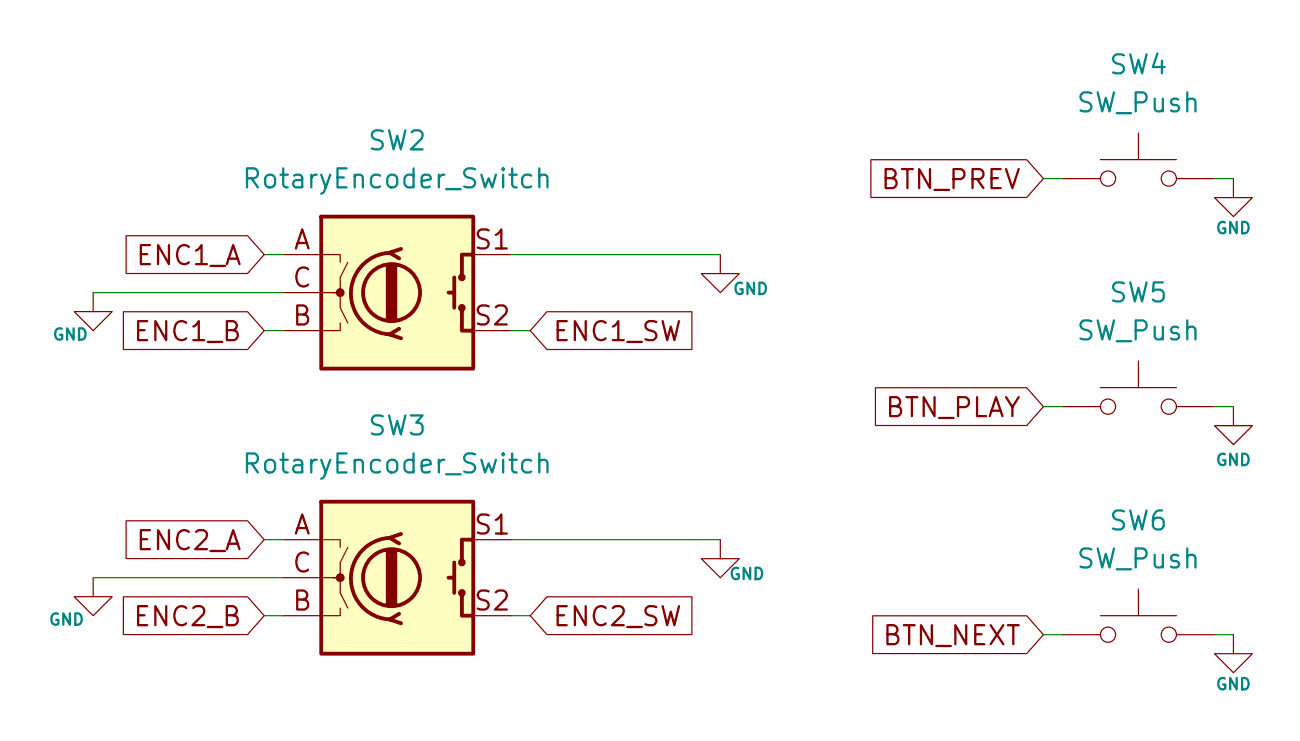
[picture p23: schematic User_Controls.kicad_sch]

Parts:
SW2, SW3: RotaryEncoder_Switch; RotaryEncoder_Alps_EC11E-Switch_Vertical_H20mm
SW4, SW5, SW6: SW_Push; SW_DIP_SPSTx01_Slide_Copal_CHS-01A_W5.08mm_P1.27mm_JPin

Connections:
BTN_NEXT: SW6.1; also elsewhere on the board
BTN_PLAY: SW5.1; also elsewhere on the board
BTN_PREV: SW4.1; also elsewhere on the board
DAC_DGND: SW2.C, SW2.S1, SW3.C, SW3.S1, SW4.2, SW5.2, SW6.2; also elsewhere on the board
ENC1_A: SW2.A; also elsewhere on the board
ENC1_B: SW2.B; also elsewhere on the board
ENC1_SW: SW2.S2; also elsewhere on the board
ENC2_A: SW3.A; also elsewhere on the board
ENC2_B: SW3.B; also elsewhere on the board
ENC2_SW: SW3.S2; also elsewhere on the board

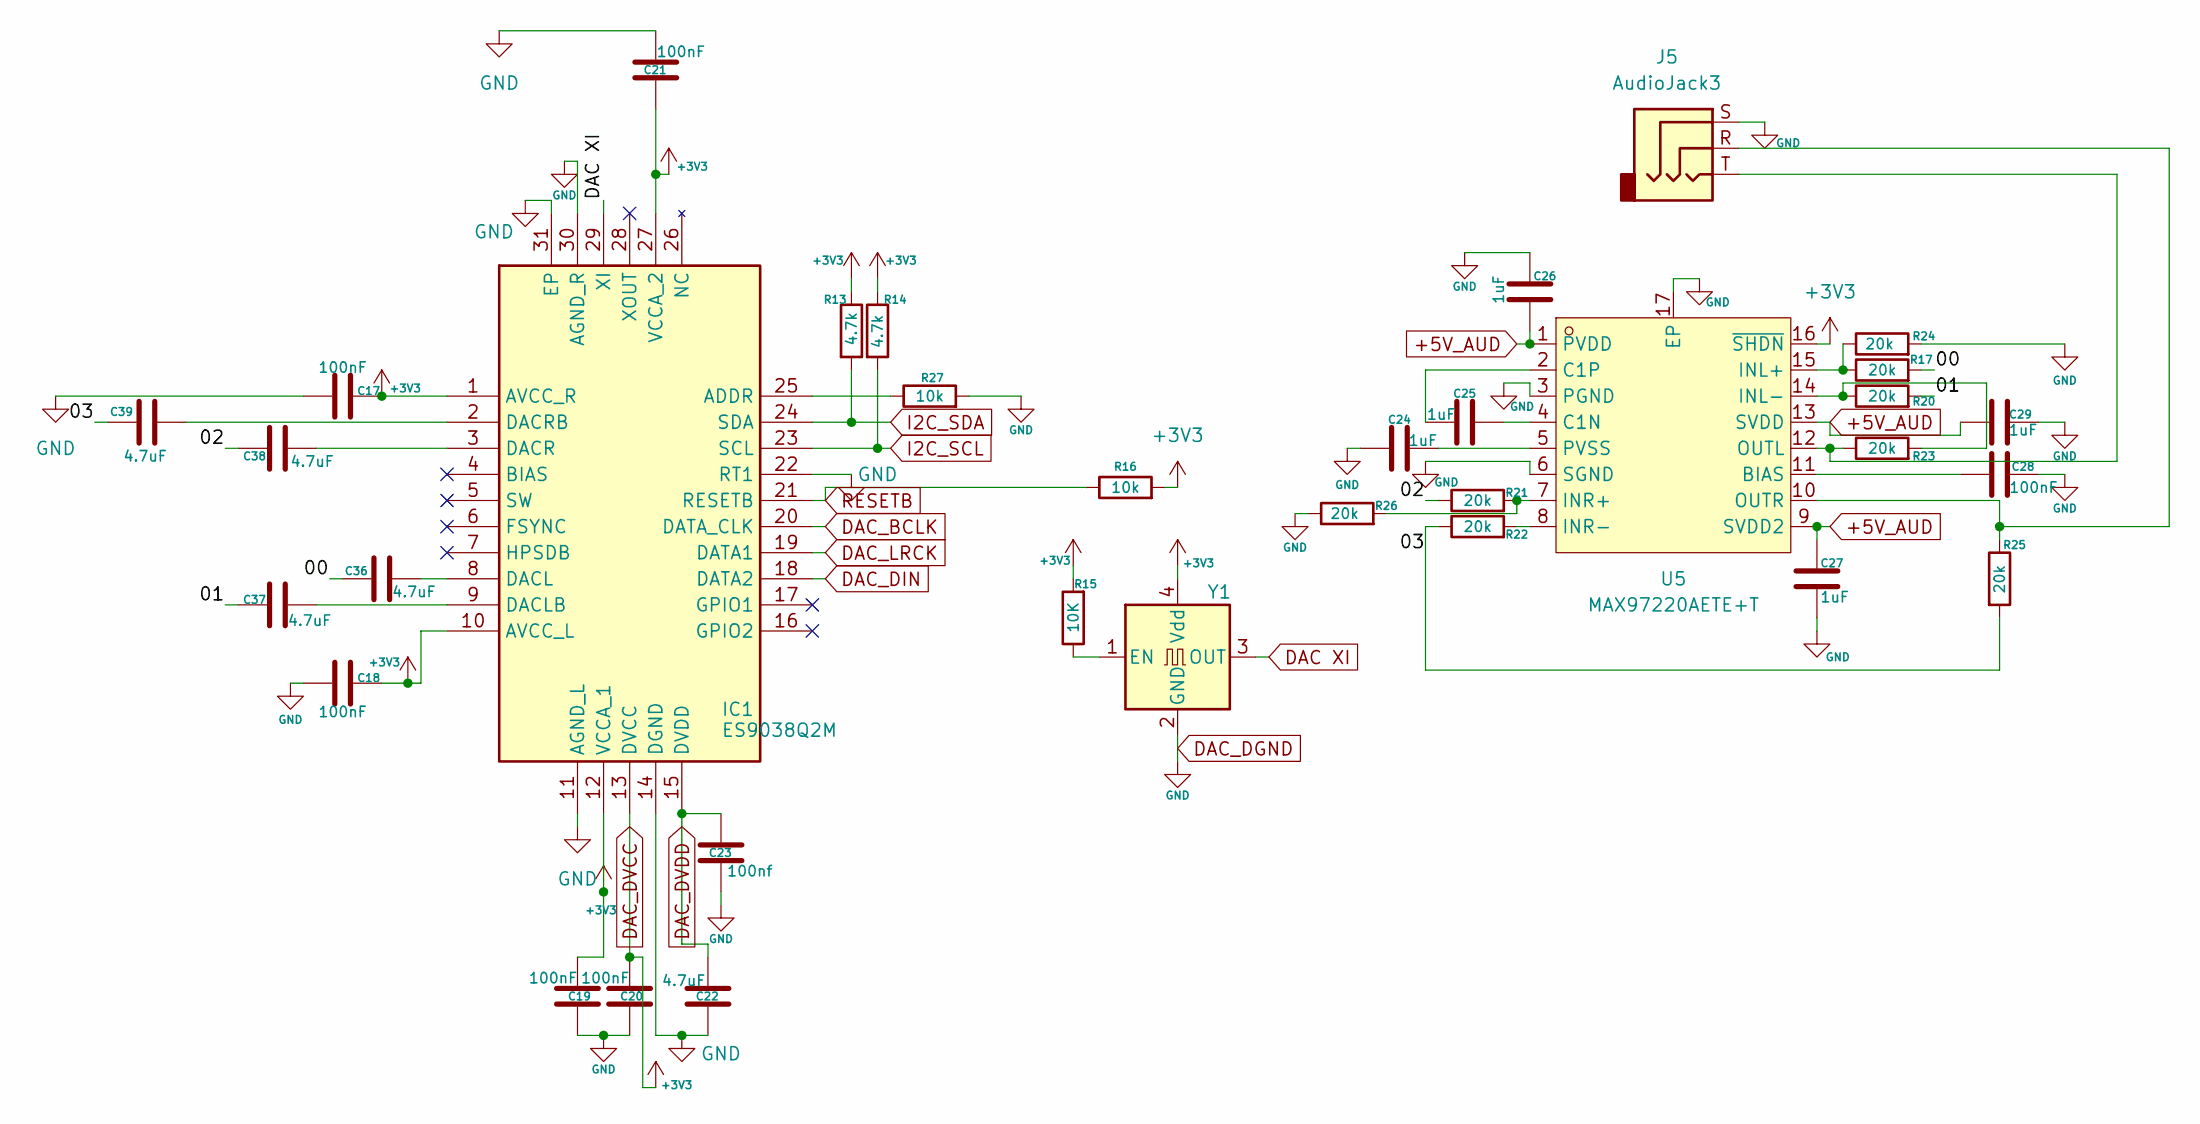
[picture p24: schematic DAC_Headphone.kicad_sch]

Parts:
C17, C18, C19, C20, C21, C28: 100nF; C_0603_1608Metric
C22, C36, C37, C38, C39: 4.7uF; C_0603_1608Metric
C23: 100nf; C_0603_1608Metric
C24, C25, C26, C27, C29: 1uF; C_0603_1608Metric
IC1: ES9038Q2M; QFN40P300X500X80-31N-D; Manufacturer_Part_Number ES9038Q2M; Mouser Part Number 460-ES9038Q2M
J5: AudioJack3; Jack_3.5mm_CUI_SJ1-3533NG_Horizontal
R13, R14: 4.7k; R_0805_2012Metric
R15: 10K; R_0805_2012Metric
R16, R27: 10k; R_0805_2012Metric
R17, R20, R21, R22, R23, R24, R25, R26: 20k; R_0805_2012Metric
U5: MAX97220AETE+T; QFN-16_L3.0-W3.0-P0.50-BL-EP1.5; MPN MAX97220AETE+T; LCSC Part C2682711
Y1: 40 MHz; Oscillator_SMD_Abracon_ASE-4Pin_3.2x2.5mm

Connections:
+5V_AUD: C26.2, C27.1, C29.1, U5.1 (PVDD), U5.9 (SVDD2), U5.13 (SVDD); also elsewhere on the board
/DAC_Headphone/00: C36.1, R17.2
/DAC_Headphone/01: C37.1, R20.2
/DAC_Headphone/02: C38.1, R21.1
/DAC_Headphone/03: C39.1, R22.1, R25.2
DAC XI: IC1.29 (XI), Y1.3 (OUT)
DAC_BCLK: IC1.20 (DATA_CLK); also elsewhere on the board
DAC_DGND: C17.2, C18.1, C19.2, C20.2, C21.1, C22.2, C23.2, C24.1, C26.1, C27.2, C28.2, C29.2, IC1.11 (AGND_L), IC1.14 (DGND), IC1.22 (RT1), IC1.30 (AGND_R), IC1.31 (EP), J5.S, R24.2, R26.1, R27.2, U5.3 (PGND), U5.6 (SGND), U5.17 (EP), Y1.2 (GND); also elsewhere on the board
DAC_DIN: IC1.18 (DATA2); also elsewhere on the board
DAC_DVCC: C17.1, C18.2, C19.1, C20.1, C21.2, IC1.1 (AVCC_R), IC1.10 (AVCC_L), IC1.12 (VCCA_1), IC1.13 (DVCC), IC1.27 (VCCA_2), R13.1, R14.1, R15.2, R16.2, U5.16 (~SHDN), Y1.4 (Vdd); also elsewhere on the board
DAC_DVDD: C22.1, C23.1, IC1.15 (DVDD)
DAC_LRCK: IC1.19 (DATA1); also elsewhere on the board
I2C_SCL: IC1.23 (SCL), R14.2; also elsewhere on the board
I2C_SDA: IC1.24 (SDA), R13.2; also elsewhere on the board
unnamed: IC1.25 (ADDR), R27.1
unnamed: C36.2, IC1.8 (DACL)
unnamed: C37.2, IC1.9 (DACLB)
unnamed: C38.2, IC1.3 (DACR)
unnamed: C39.2, IC1.2 (DACRB)
unnamed: C28.1, U5.11 (BIAS)
unnamed: C25.2, U5.4 (C1N)
unnamed: C25.1, U5.2 (C1P)
unnamed: R17.1, R24.1, U5.15 (INL+)
unnamed: R20.1, R23.2, U5.14 (INL-)
unnamed: R21.2, R26.2, U5.7 (INR+)
unnamed: R22.2, U5.8 (INR-)
unnamed: J5.T, R23.1, U5.12 (OUTL)
unnamed: J5.R, R25.1, U5.10 (OUTR)
unnamed: C24.2, U5.5 (PVSS)
unnamed: R15.1, Y1.1 (EN)
RESETB: IC1.21 (RESETB), R16.1; also elsewhere on the board

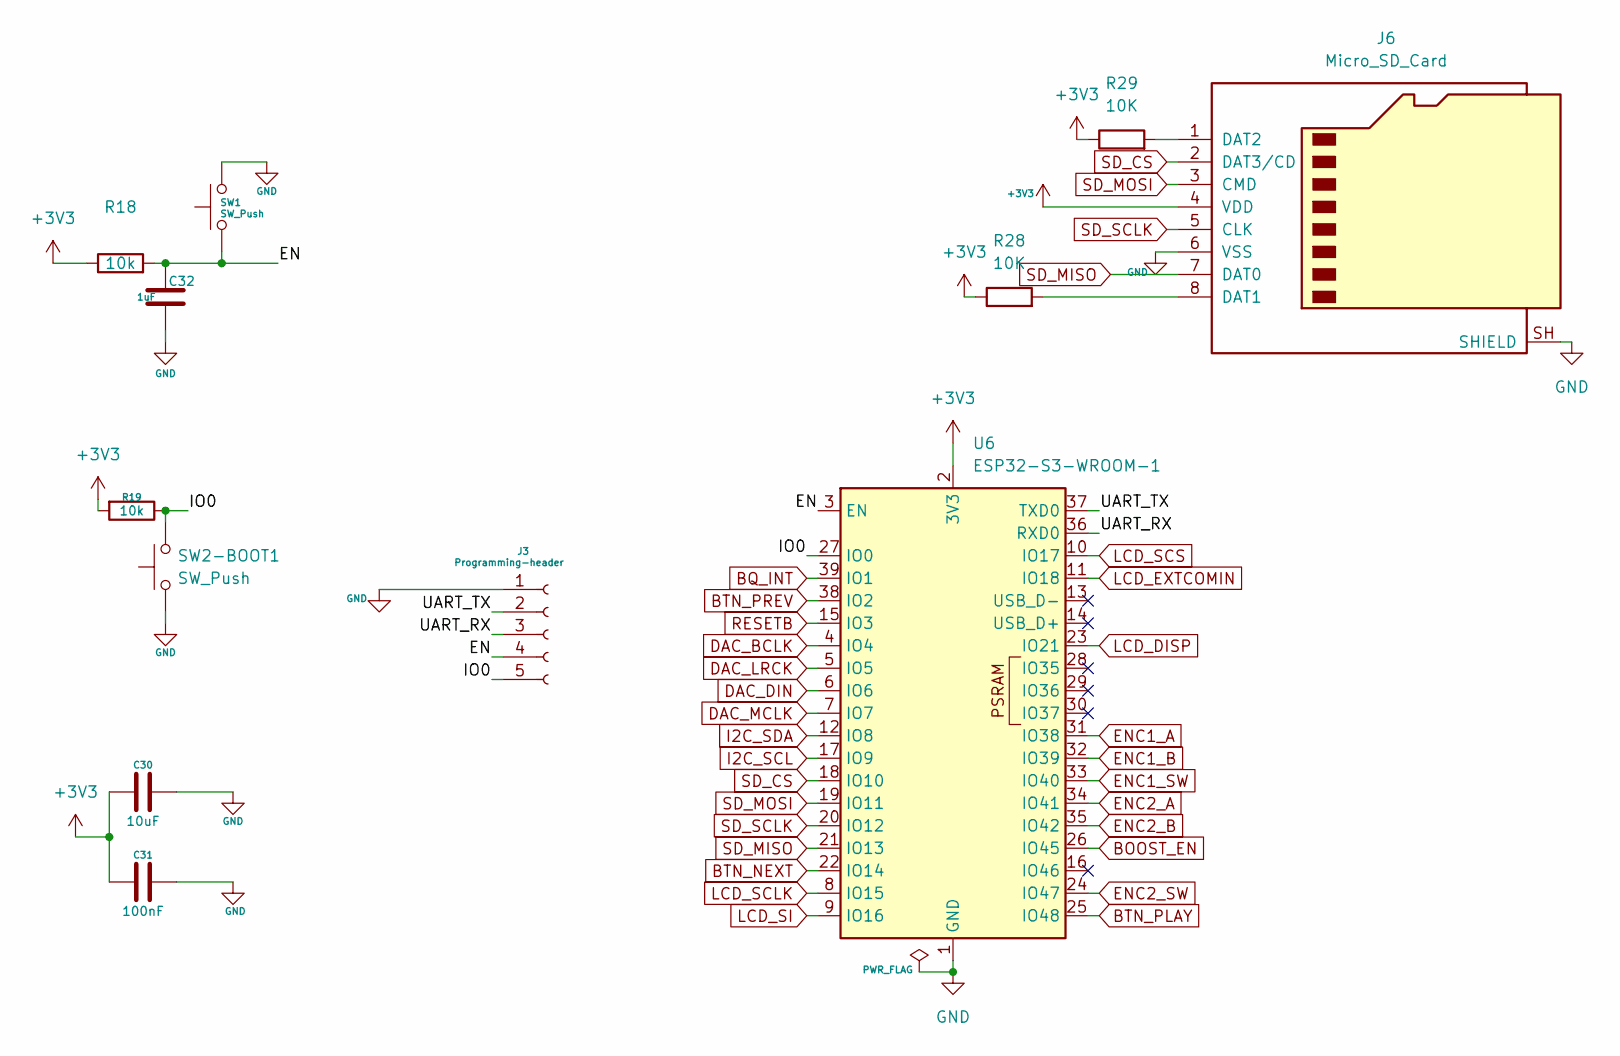
[picture p25: schematic ESP32S3_Core.kicad_sch]

Parts:
C30: 10uF; C_0603_1608Metric
C31: 100nF; C_0603_1608Metric
C32: 1uF; C_0603_1608Metric
J3: Programming-header; PinHeader_1x05_P2.54mm_Vertical
J6: Micro_SD_Card; microSD_HC_Hirose_DM3AT-SF-PEJM5
R18, R19: 10k; R_0805_2012Metric
R28, R29: 10K; R_0805_2012Metric
SW1, SW2-BOOT1: SW_Push; SW_DIP_SPSTx01_Slide_Copal_CHS-01A_W5.08mm_P1.27mm_JPin
U6: ESP32-S3-WROOM-1

Connections:
/ESP32S3_Core/EN: C32.2, J3.4, R18.2, SW1.1, U6.3 (EN)
/ESP32S3_Core/IO0: J3.5, R19.1, SW2-BOOT1.2, U6.27 (IO0)
/ESP32S3_Core/UART_RX: J3.3, U6.36 (RXD0)
/ESP32S3_Core/UART_TX: J3.2, U6.37 (TXD0)
BOOST_EN: U6.26 (IO45); also elsewhere on the board
BQ_INT: U6.39 (IO1); also elsewhere on the board
BTN_NEXT: U6.22 (IO14); also elsewhere on the board
BTN_PLAY: U6.25 (IO48); also elsewhere on the board
BTN_PREV: U6.38 (IO2); also elsewhere on the board
DAC_BCLK: U6.4 (IO4); also elsewhere on the board
DAC_DGND: C30.2, C31.2, C32.1, J3.1, J6.6 (VSS), J6.SH (SHIELD), SW1.2, SW2-BOOT1.1, U6.1 (GND), U6.40 (GND), U6.41 (GND); also elsewhere on the board
DAC_DIN: U6.6 (IO6); also elsewhere on the board
DAC_DVCC: C30.1, C31.1, J6.4 (VDD), R18.1, R19.2, R28.1, R29.1, U6.2 (3V3); also elsewhere on the board
DAC_LRCK: U6.5 (IO5); also elsewhere on the board
DAC_MCLK: U6.7 (IO7)
ENC1_A: U6.31 (IO38); also elsewhere on the board
ENC1_B: U6.32 (IO39); also elsewhere on the board
ENC1_SW: U6.33 (IO40); also elsewhere on the board
ENC2_A: U6.34 (IO41); also elsewhere on the board
ENC2_B: U6.35 (IO42); also elsewhere on the board
ENC2_SW: U6.24 (IO47); also elsewhere on the board
I2C_SCL: U6.17 (IO9); also elsewhere on the board
I2C_SDA: U6.12 (IO8); also elsewhere on the board
LCD_DISP: U6.23 (IO21); also elsewhere on the board
LCD_EXTCOMIN: U6.11 (IO18); also elsewhere on the board
LCD_SCLK: U6.8 (IO15); also elsewhere on the board
LCD_SCS: U6.10 (IO17); also elsewhere on the board
LCD_SI: U6.9 (IO16); also elsewhere on the board
unnamed: J6.8 (DAT1), R28.2
unnamed: J6.1 (DAT2), R29.2
RESETB: U6.15 (IO3); also elsewhere on the board
SD_CS: J6.2 (DAT3/CD), U6.18 (IO10)
SD_MISO: J6.7 (DAT0), U6.21 (IO13)
SD_MOSI: J6.3 (CMD), U6.19 (IO11)
SD_SCLK: J6.5 (CLK), U6.20 (IO12)

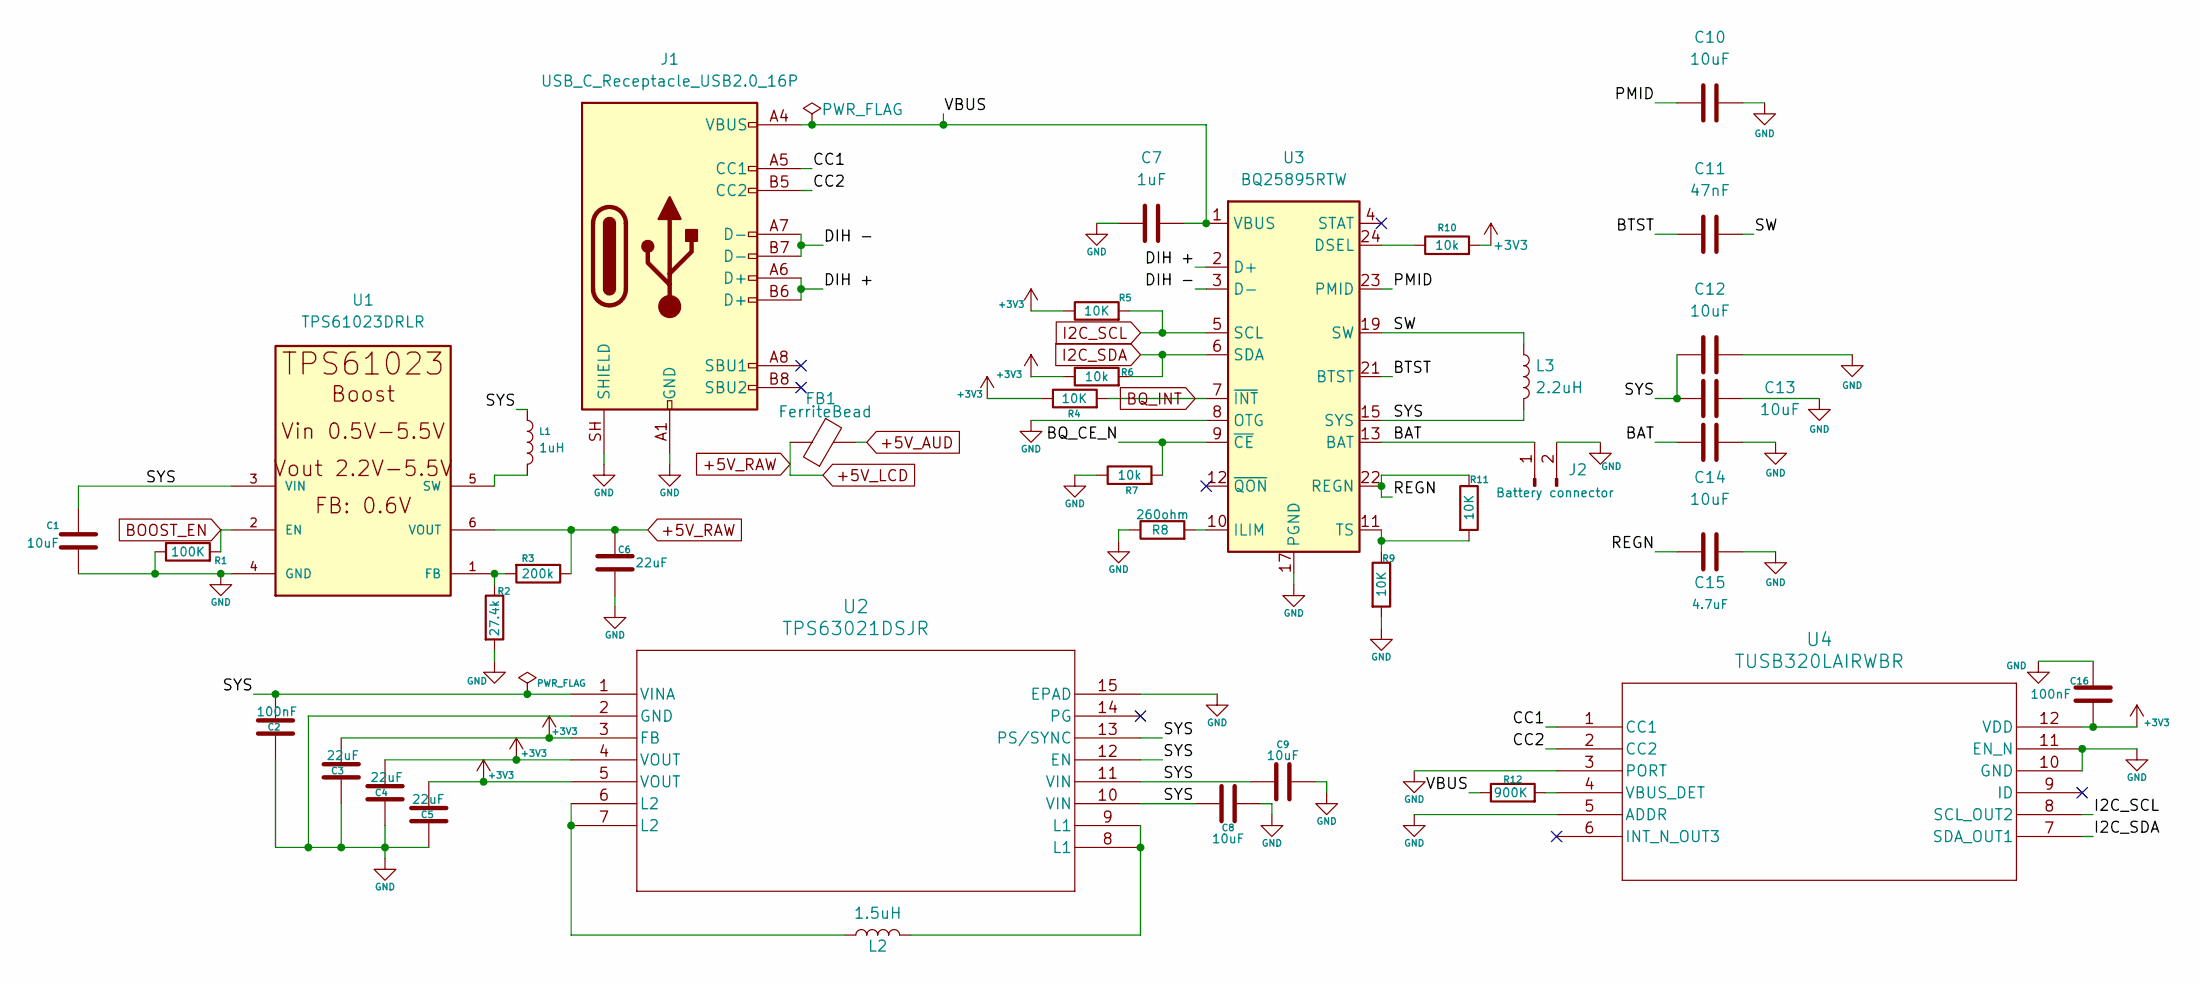
[picture p26: schematic Power_Management.kicad_sch]

Parts:
C1, C8, C9, C10, C12, C13, C14: 10uF; C_0603_1608Metric
C2, C16: 100nF; C_0603_1608Metric
C3, C4, C5, C6: 22uF; C_0603_1608Metric
C7: 1uF; C_0603_1608Metric
C11: 47nF; C_0603_1608Metric
C15: 4.7uF; C_0603_1608Metric
FB1: FerriteBead; L_0805_2012Metric
J1: USB_C_Receptacle_USB2.0_16P; USB_C_Receptacle_GCT_USB4105-xx-A_16P_TopMnt_Horizontal
J2: Battery connector; PinHeader_1x02_P2.54mm_Vertical
L1: 1uH; L_0805_2012Metric
L2: 1.5uH; L_0805_2012Metric
L3: 2.2uH; L_0805_2012Metric
R1: 100K; R_0805_2012Metric
R2: 27.4k; R_0805_2012Metric
R3: 200k; R_0805_2012Metric
R4, R5, R9, R11: 10K; R_0805_2012Metric
R6, R7, R10: 10k; R_0805_2012Metric
R8: 260ohm; R_0805_2012Metric
R12: 900K; R_0805_2012Metric
U1: TPS61023DRLR; SOT563-ORI; MPN TPS61023DRLR
U2: TPS63021DSJR; DSJ14_2P85X1P58
U3: BQ25895RTW; Texas_RTW_WQFN-24-1EP_4x4mm_P0.5mm_EP2.7x2.7mm_ThermalVias
U4: TUSB320LAIRWBR; RWB0012A_TEX

Connections:
+5V_AUD: FB1.2; also elsewhere on the board
+5V_LCD: C6.1, FB1.1, R3.1, U1.6 (VOUT); also elsewhere on the board
/Power_Management/BAT: C14.1, J2.1, U3.13 (BAT), U3.14 (BAT)
/Power_Management/BQ_CE_N: R7.2, U3.9 (~CE)
/Power_Management/BTST: C11.1, U3.21 (BTST)
/Power_Management/CC1: J1.A5 (CC1), U4.1 (CC1)
/Power_Management/CC2: J1.B5 (CC2), U4.2 (CC2)
/Power_Management/DIH +: J1.A6 (D+), J1.B6 (D+), U3.2 (D+)
/Power_Management/DIH -: J1.A7 (D-), J1.B7 (D-), U3.3 (D-)
/Power_Management/PMID: C10.1, U3.23 (PMID)
/Power_Management/REGN: C15.1, R11.1, U3.22 (REGN)
/Power_Management/SW: C11.2, L3.1, U3.19 (SW), U3.20 (SW)
/Power_Management/SYS: C1.1, C2.1, C8.1, C9.1, C12.1, C13.1, L1.1, L3.2, U1.3 (VIN), U2.1 (VINA), U2.10 (VIN), U2.11 (VIN), U2.12 (EN), U2.13 (PS/SYNC), U3.15 (SYS), U3.16 (SYS)
/Power_Management/VBUS: C7.2, J1.A4 (VBUS), J1.A9 (VBUS), J1.B4 (VBUS), J1.B9 (VBUS), R12.1, U3.1 (VBUS)
BOOST_EN: R1.2, U1.2 (EN); also elsewhere on the board
BQ_INT: R4.2, U3.7 (~INT); also elsewhere on the board
DAC_DGND: C1.2, C2.2, C3.2, C4.2, C5.2, C6.2, C7.1, C8.2, C9.2, C10.2, C12.2, C13.2, C14.2, C15.2, C16.1, J1.A1 (GND), J1.A12 (GND), J1.B1 (GND), J1.B12 (GND), J1.SH (SHIELD), J2.2, R1.1, R2.2, R7.1, R8.1, R9.2, U1.4 (GND), U2.2 (GND), U2.15 (EPAD), U3.8 (OTG), U3.17 (PGND), U3.18 (PGND), U3.25 (PGND), U4.3 (PORT), U4.5 (ADDR), U4.10 (GND), U4.11 (EN_N); also elsewhere on the board
DAC_DVCC: C3.1, C4.1, C5.1, C16.2, R4.1, R5.1, R6.1, R10.2, U2.3 (FB), U2.4 (VOUT), U2.5 (VOUT), U4.12 (VDD); also elsewhere on the board
I2C_SCL: R5.2, U3.5 (SCL), U4.8 (SCL_OUT2); also elsewhere on the board
I2C_SDA: R6.2, U3.6 (SDA), U4.7 (SDA_OUT1); also elsewhere on the board
unnamed: L2.1, U2.6 (L2), U2.7 (L2)
unnamed: L2.2, U2.8 (L1), U2.9 (L1)
unnamed: R2.1, R3.2, U1.1 (FB)
unnamed: L1.2, U1.5 (SW)
unnamed: R10.1, U3.24 (DSEL)
unnamed: R8.2, U3.10 (ILIM)
unnamed: R9.1, R11.2, U3.11 (TS)
unnamed: R12.2, U4.4 (VBUS_DET)

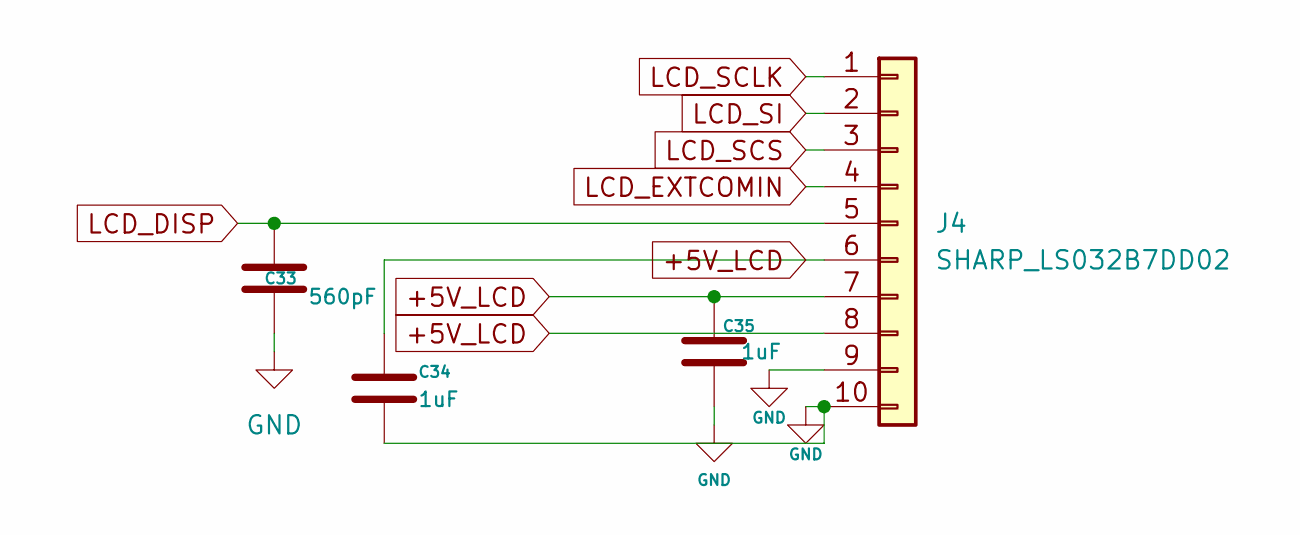
[picture p27: schematic Display_Controls.kicad_sch]

Parts:
C33: 560pF; C_0603_1608Metric
C34, C35: 1uF; C_0603_1608Metric
J4: SHARP_LS032B7DD02; HRS_FH34SRJ-10S-0.5SH_50_

Connections:
+5V_LCD: C34.1, C35.1, J4.6, J4.7, J4.8; also elsewhere on the board
DAC_DGND: C33.2, C34.2, C35.2, J4.9, J4.10; also elsewhere on the board
LCD_DISP: C33.1, J4.5; also elsewhere on the board
LCD_EXTCOMIN: J4.4; also elsewhere on the board
LCD_SCLK: J4.1; also elsewhere on the board
LCD_SCS: J4.3; also elsewhere on the board
LCD_SI: J4.2; also elsewhere on the board

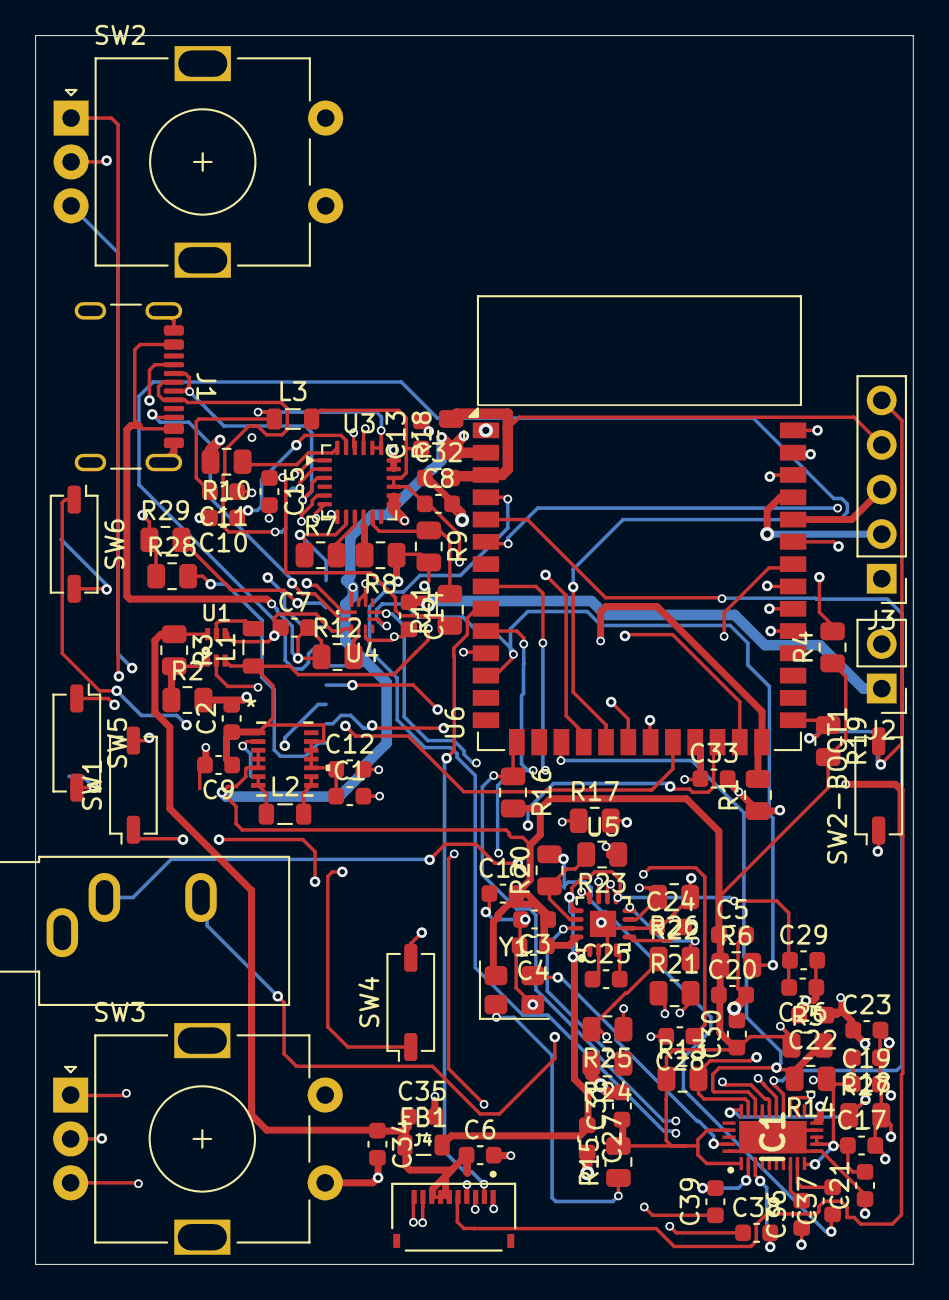
[picture p28: board DAP'S PCB/DAP'S PCB.kicad_pcb from above]

Board: 4 copper layers, 50.0 x 70.0 mm, 93 parts (1 on the bottom side), 78 nets.
