Oru-star/Unique-DAP/DAP'S PCB/_restore_backup_2026-10-29T08-32-35-416/DAP'S PCB.kicad_pcb

## KiCad design DAP'S PCB/_restore_backup_2026-10-29T08-32-35-416/DAP'S PCB.kicad_pcb (2026-11-07)

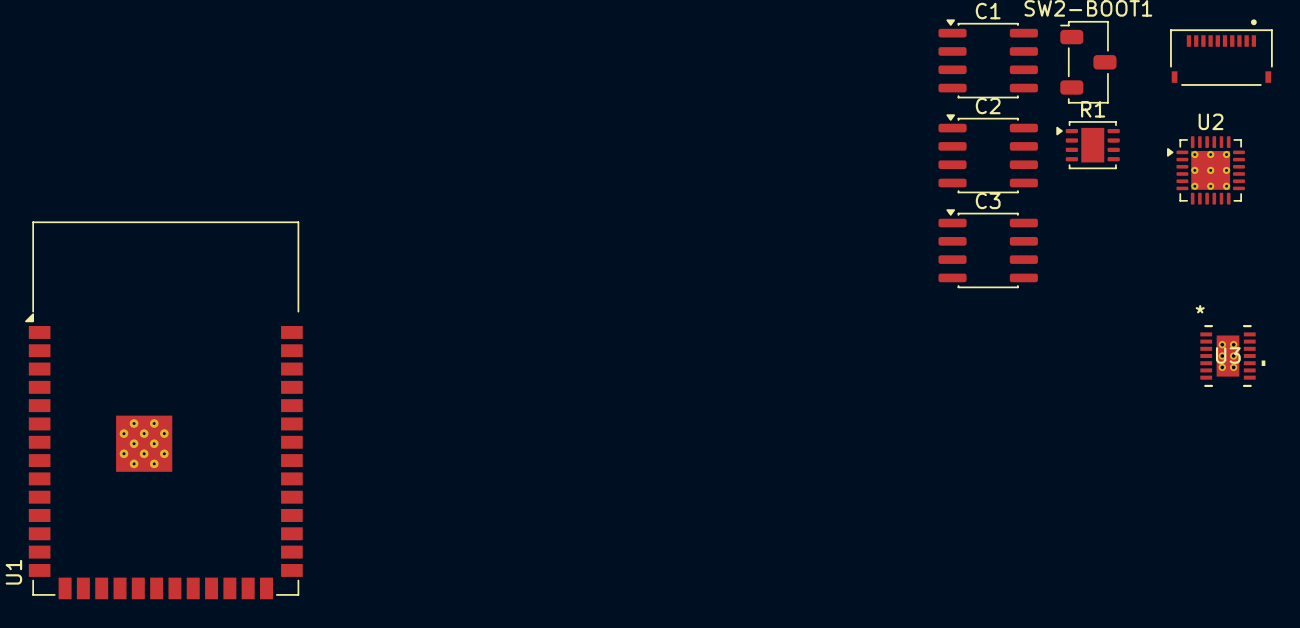
[picture p29: board DAP'S PCB/_restore_backup_2026-10-29T08-32-35-416/DAP'S PCB.kicad_pcb from above]

Board: 2 copper layers, 9 parts (0 on the bottom side), 15 nets, no tracks yet.

Parts:
C1: 1uF; SOIC-8_3.9x4.9mm_P1.27mm
C2: 10uF; SOIC-8_3.9x4.9mm_P1.27mm
C3: 100nF; SOIC-8_3.9x4.9mm_P1.27mm
J1: SHARP_LS032B7DD02; HRS_FH34SRJ-10S-0.5SH_50_
R1: 10k; HVSON-8-1EP_3x3mm_P0.65mm_EP1.6x2.4mm
SW2-BOOT1: SW_Push; Nidec_Copal_CAS-120A
U1: ESP32-S3-WROOM-1
U2: BQ25895RTW; Texas_RTW_WQFN-24-1EP_4x4mm_P0.5mm_EP2.7x2.7mm_ThermalVias
U3: TPS63021DSJR; DSJ14_2P85X1P58

Connections:
+3V3: C2.1, C3.1, R1.1, U1.2 (3V3)
+5V_LCD: J1.6, J1.7, J1.8
/ESP32S3_Core/EN: C1.2, R1.2, U1.3 (EN)
/ESP32S3_Core/IO0: SW2-BOOT1.2, U1.27 (IO0)
/Power_Management/BAT: U2.13 (BAT), U2.14 (BAT)
/Power_Management/SW: U2.19 (SW), U2.20 (SW)
/Power_Management/SYS: U2.15 (SYS), U2.16 (SYS)
GND: C1.1, C2.2, C3.2, J1.9, J1.10, SW2-BOOT1.1, U1.1 (GND), U1.40 (GND), U1.41 (GND), U2.8 (OTG), U2.9 (~CE), U2.17 (PGND), U2.18 (PGND), U2.25 (PGND)
I2C_SCL: U1.17 (IO9), U2.5 (SCL)
I2C_SDA: U1.12 (IO8), U2.6 (SDA)
LCD_DISP: J1.5, U1.23 (IO21)
LCD_EXTCOMIN: J1.4, U1.11 (IO18)
LCD_SCLK: J1.1, U1.8 (IO15)
LCD_SCS: J1.3, U1.10 (IO17)
LCD_SI: J1.2, U1.9 (IO16)
